liviu201/uSDX_variant/README.md

For information about configuring KiCad for this project, go to [Configuring_KiCad.md](./Configuring_KiCad.md)
