liviu201/uSDX_variant/Hardware/3D_models/RASM722BKZ.FCStd

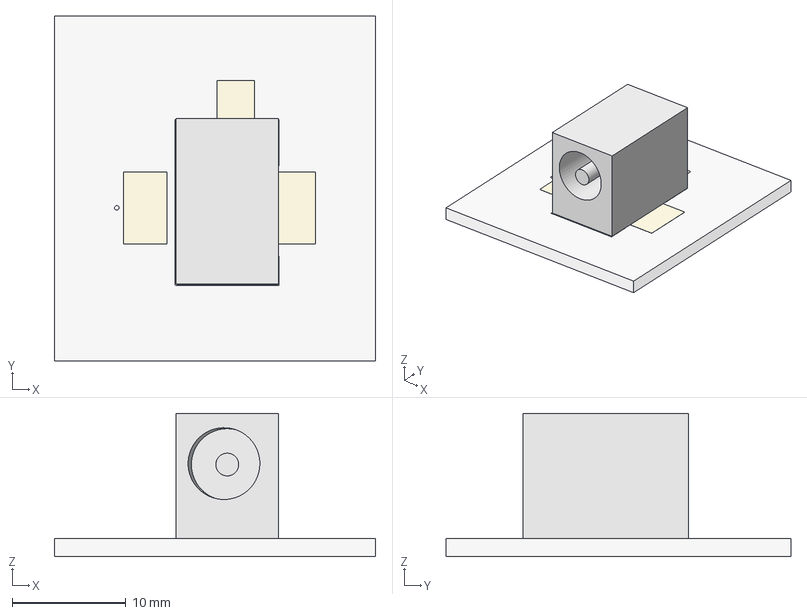
[picture p6: CAD file, 2021-12-31]
Hardware/3D_models/RASM722BKZ.FCStd
28.2 x 30.3 x 12.6 mm
FrontSilk
TopPads
Pcb
