liviu201/uSDX_variant/Hardware/3D_models/C_0805_2012Metric.step

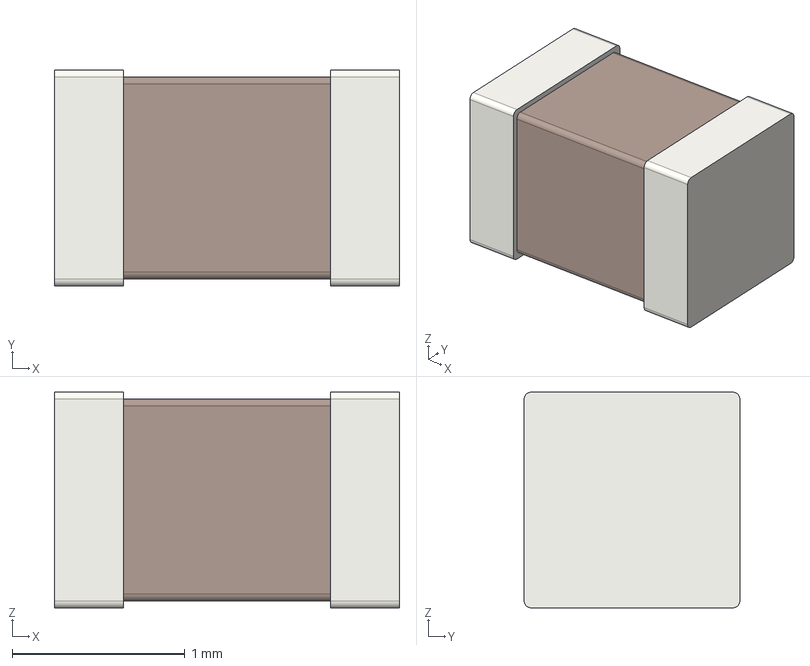
[picture p7: CAD file, 2022-01-15]
Hardware/3D_models/C_0805_2012Metric.step
2.00 x 1.25 x 1.25 mm
