liviu201/uSDX_variant/Hardware/3D_models/SamacSys_3D_Models/AZ1117CH-5.0TRG1DITR-ND.step

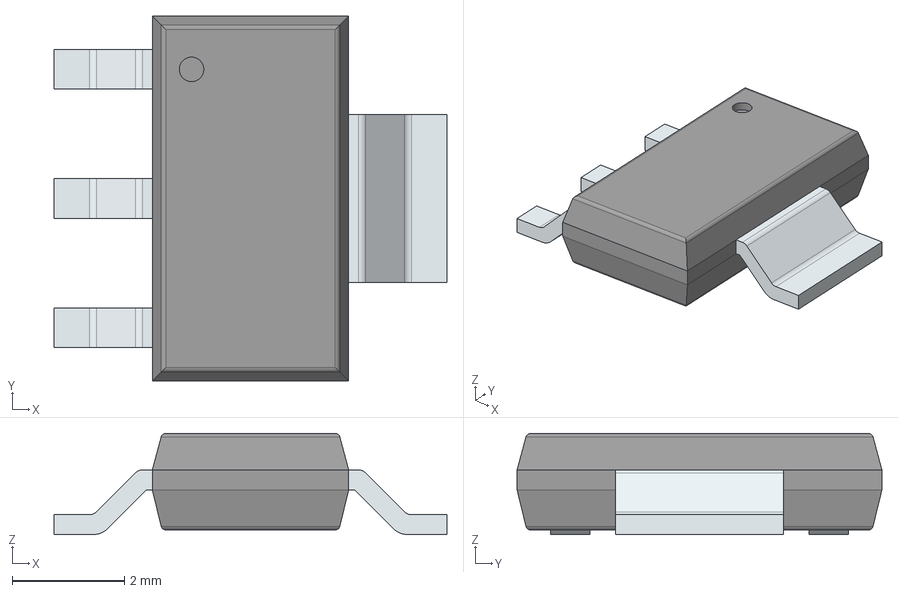
[picture p8: CAD file, 2022-01-12]
Hardware/3D_models/SamacSys_3D_Models/AZ1117CH-5.0TRG1DITR-ND.step
7.00 x 6.50 x 1.80 mm
PinsArrayL
FilletPinR
