liviu201/uSDX_variant/Hardware/3D_models/C_Disc_D3.0mm_W1.6mm_P2.50mm.step

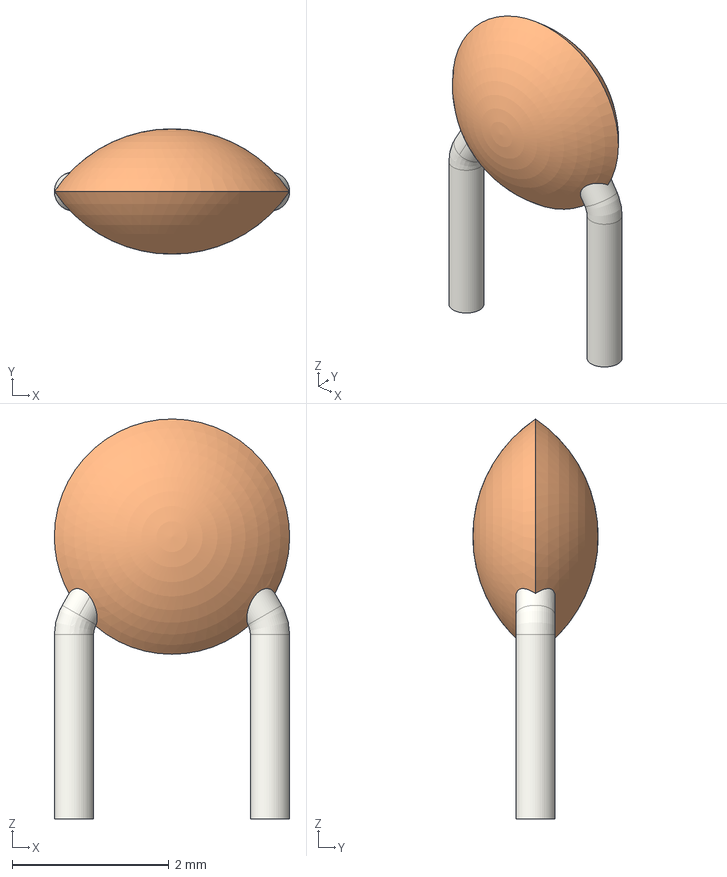
[picture p9: CAD file, 2022-01-15]
Hardware/3D_models/C_Disc_D3.0mm_W1.6mm_P2.50mm.step
3.00 x 1.60 x 5.10 mm
