liviu201/uSDX_variant/Hardware/3D_models/SamacSys_3D_Models/ECS-200-20-20BM-DP.step

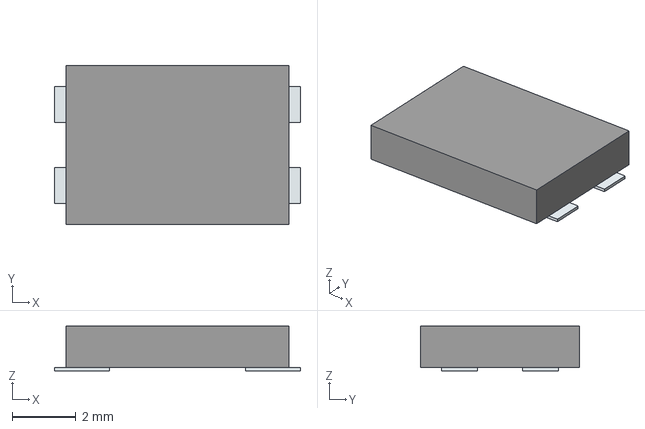
[picture p10: CAD file, 2022-01-09]
Hardware/3D_models/SamacSys_3D_Models/ECS-200-20-20BM-DP.step
7.72 x 5.00 x 1.40 mm
Pins
