liviu201/uSDX_variant/Hardware/3D_models/R_0805_2012Metric.step

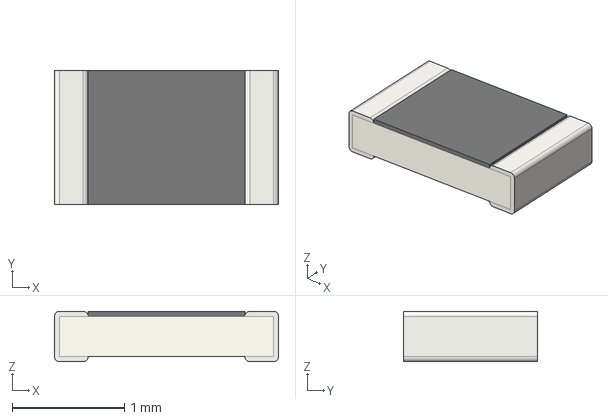
[picture p11: CAD file, 2022-01-15]
Hardware/3D_models/R_0805_2012Metric.step
2.00 x 1.20 x 0.45 mm
