liviu201/uSDX_variant/Hardware/3D_models/SamacSys_3D_Models/1N4007F.step

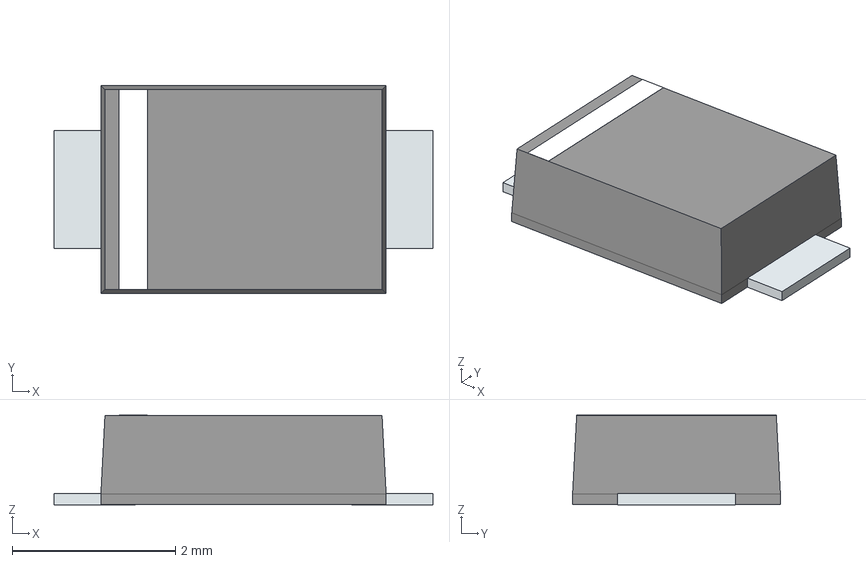
[picture p12: CAD file, 2022-01-09]
Hardware/3D_models/SamacSys_3D_Models/1N4007F.step
4.65 x 2.55 x 1.10 mm
PinKIdent
PinK
PinA
