liviu201/uSDX_variant/Hardware/3D_models/SamacSys_3D_Models/NE555DR.step

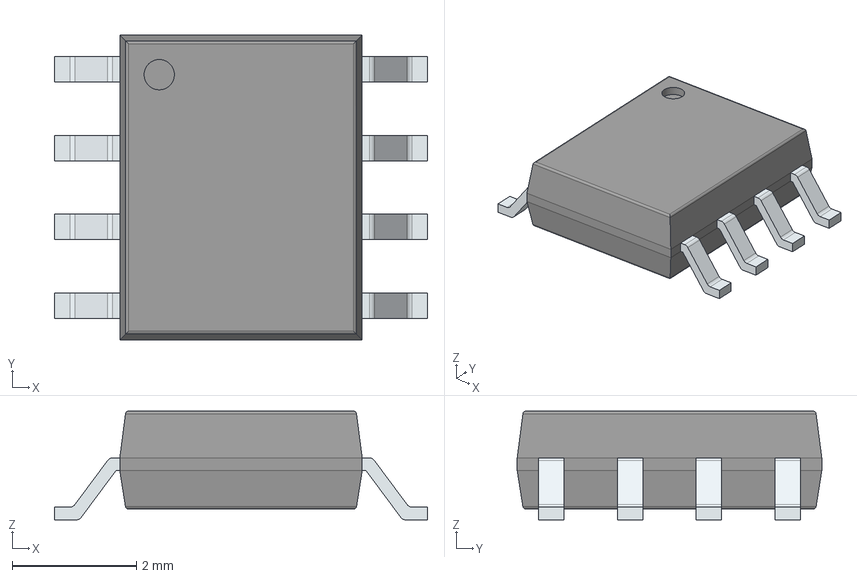
[picture p13: CAD file, 2022-01-09]
Hardware/3D_models/SamacSys_3D_Models/NE555DR.step
6.00 x 4.90 x 1.75 mm
PinsArrayLR
