liviu201/uSDX_variant/Hardware/3D_models/Toroid.step

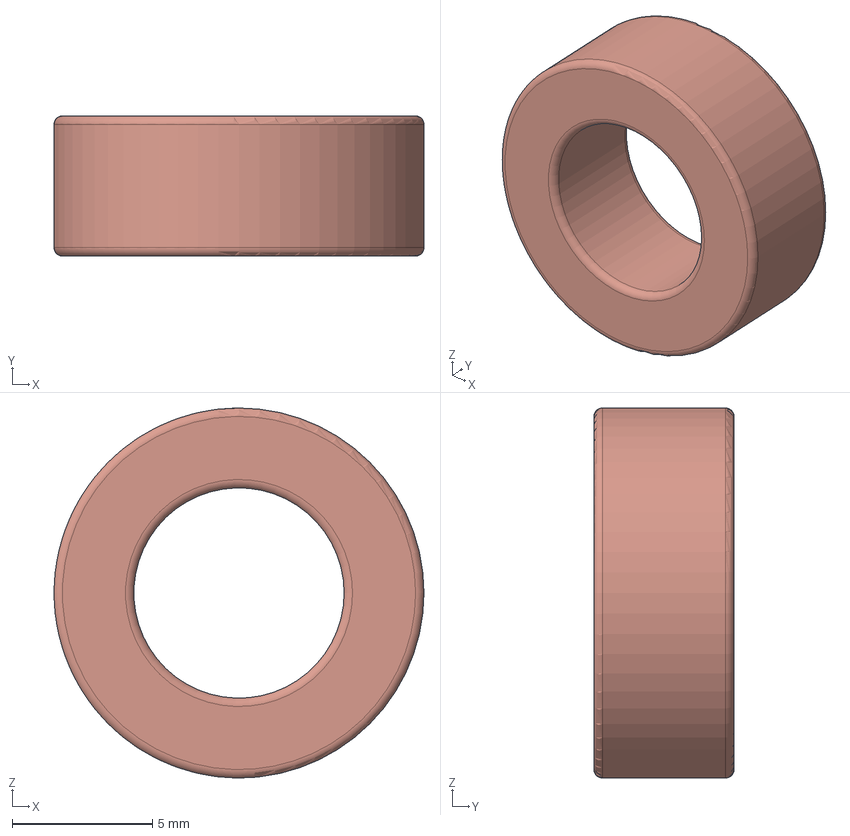
[picture p14: CAD file, 2022-01-15]
Hardware/3D_models/Toroid.step
13.2 x 5.00 x 13.2 mm
