liviu201/uSDX_variant/Hardware/3D_models/SamacSys_3D_Models/SI5351A-B-GTR.step

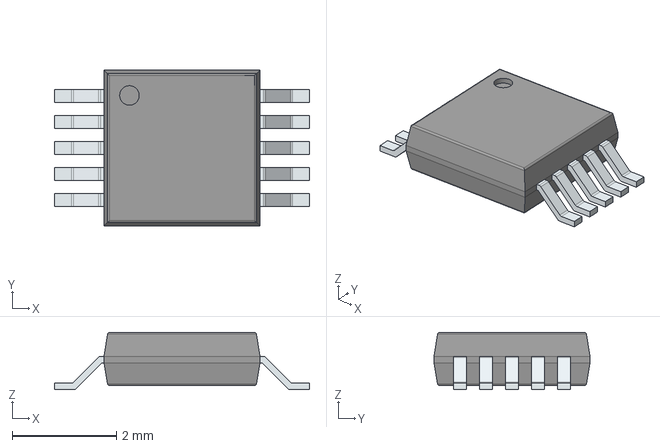
[picture p15: CAD file, 2022-01-09]
Hardware/3D_models/SamacSys_3D_Models/SI5351A-B-GTR.step
4.90 x 3.00 x 1.10 mm
PinsArrayLR
