liviu201/uSDX_variant/Hardware/3D_models/uSDX_BPF.step

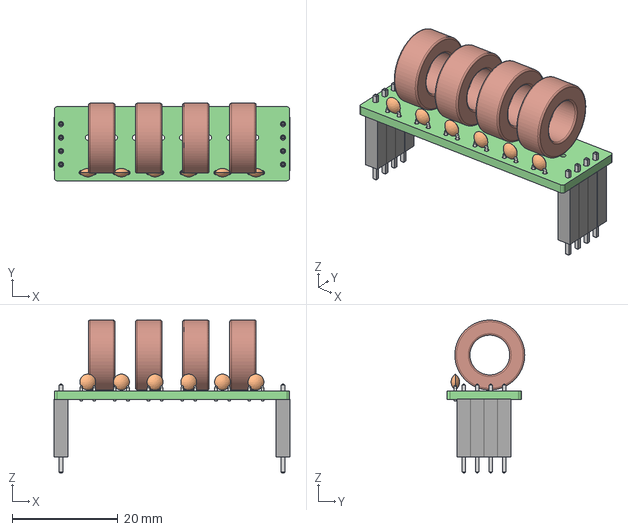
[picture p16: CAD file, 2022-01-15]
Hardware/3D_models/uSDX_BPF.step
44.5 x 14.6 x 28.8 mm
