liviu201/uSDX_variant/Hardware/3D_models/filterStandoff.step

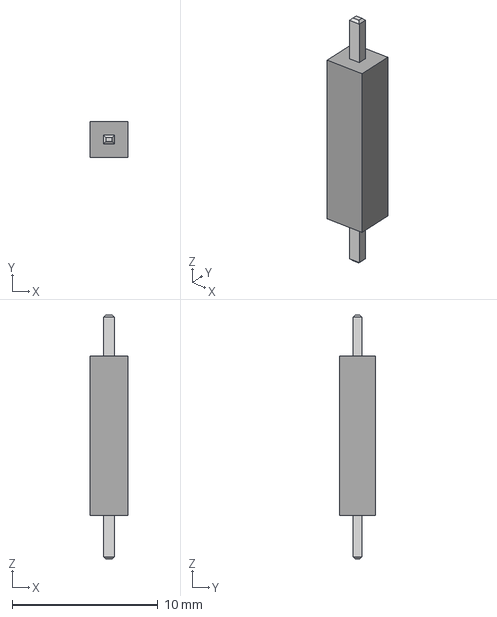
[picture p17: CAD file, 2022-01-15]
Hardware/3D_models/filterStandoff.step
2.64 x 2.50 x 16.8 mm
