liviu201/uSDX_variant/Hardware/3D_models/BPF_board.FCStd

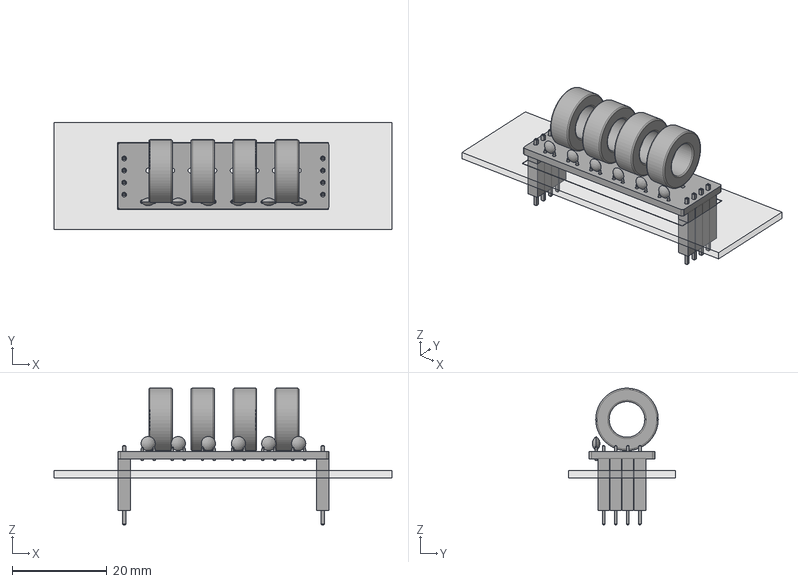
[picture p18: CAD file, 2022-01-15]
Hardware/3D_models/BPF_board.FCStd
71.3 x 22.5 x 28.8 mm
FrontSilk
TopPads
BotPads
PTHs
Pcb
uSDX_BPF
