liviu201/uSDX_variant/Hardware/3D_models/SamacSys_3D_Models/1613_14.step

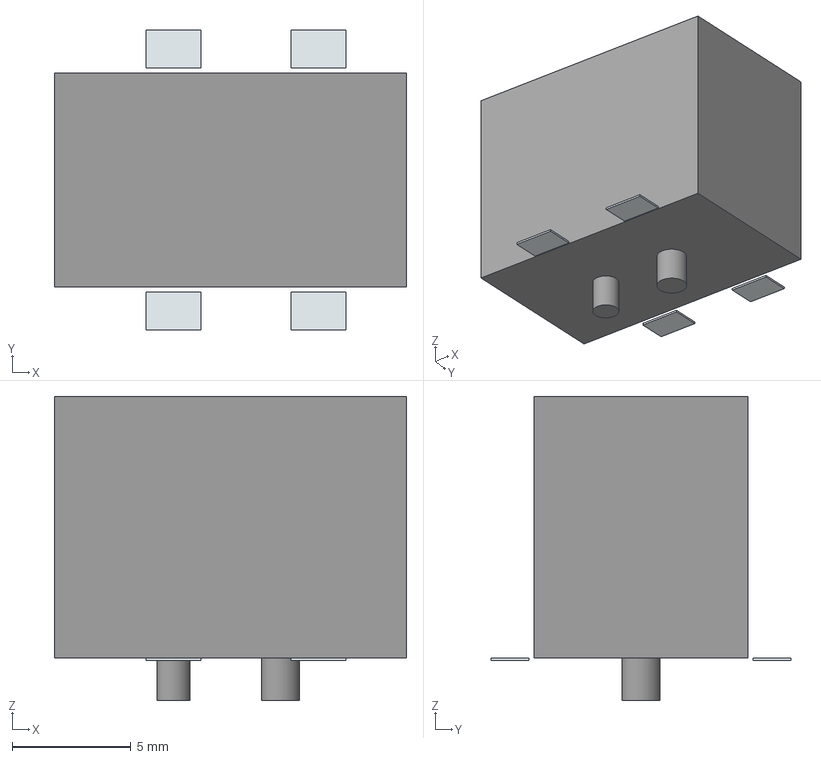
[picture p19: CAD file, 2022-01-09]
Hardware/3D_models/SamacSys_3D_Models/1613_14.step
14.8 x 12.6 x 12.8 mm
Pins
Lugs
