liviu201/uSDX_variant/Hardware/3D_models/resetButton.step

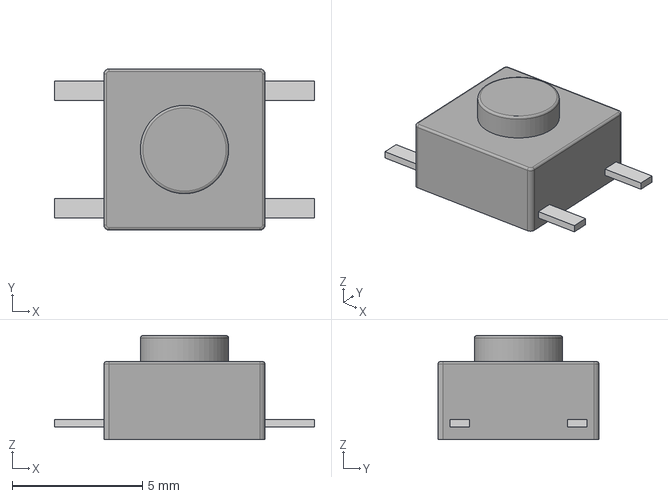
[picture p20: CAD file, 2022-01-13]
Hardware/3D_models/resetButton.step
10.0 x 6.20 x 4.00 mm
