liviu201/uSDX_variant/Hardware/3D_models/SamacSys_3D_Models/UCQ1C100MCL1GB.step

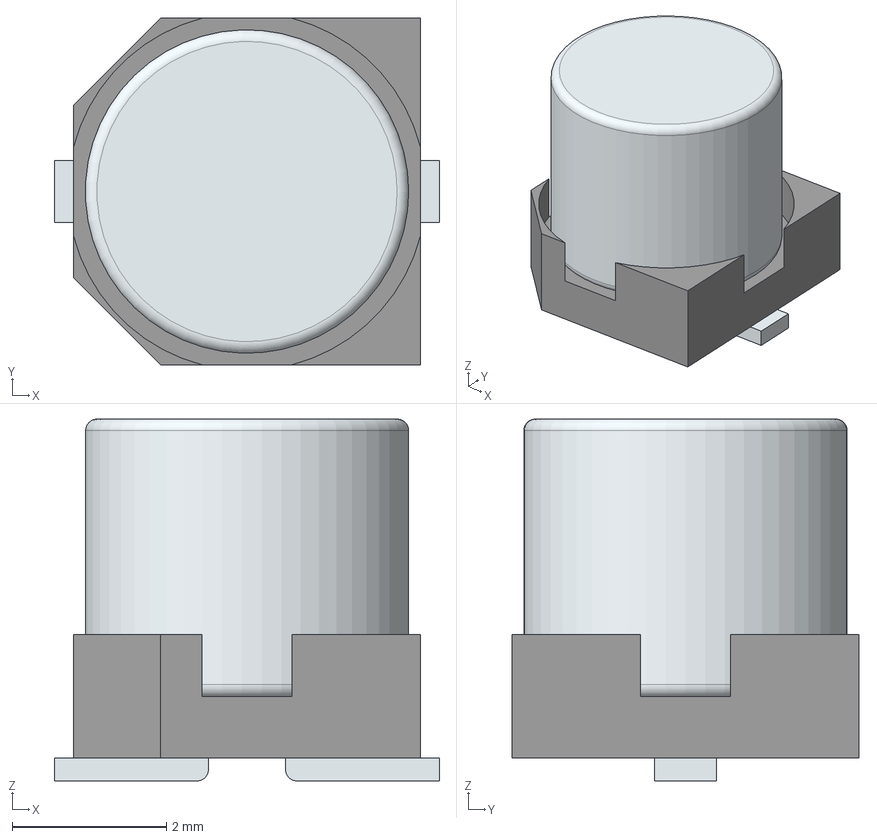
[picture p21: CAD file, 2022-01-09]
Hardware/3D_models/SamacSys_3D_Models/UCQ1C100MCL1GB.step
5.00 x 4.50 x 4.70 mm
Base
Pin1Fillet
Pin2Fillet
