liviu201/uSDX_variant/Hardware/3D_models/27Mhz_crystal.step

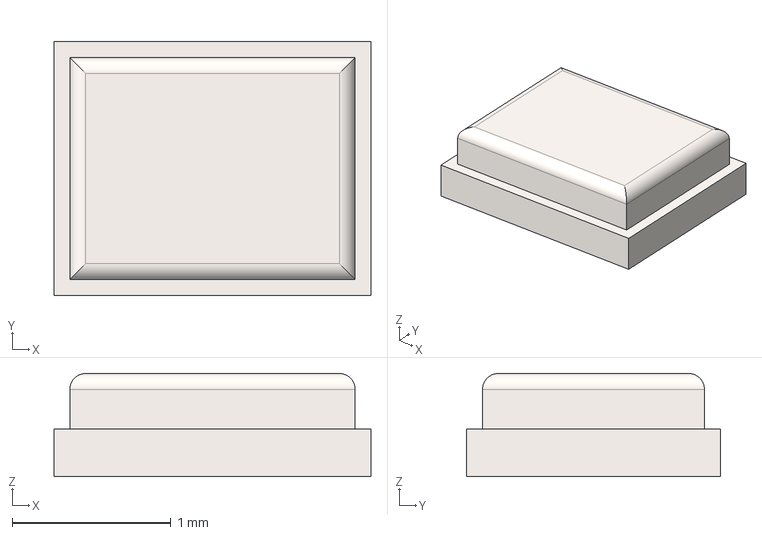
[picture p22: CAD file, 2022-01-13]
Hardware/3D_models/27Mhz_crystal.step
2.00 x 1.60 x 0.65 mm
