liviu201/uSDX_variant/Hardware/3D_models/SamacSys_3D_Models/PTS125SM122LFS.step

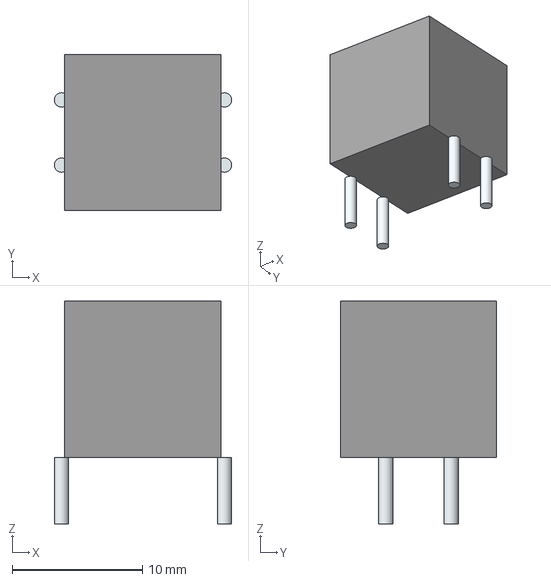
[picture p23: CAD file, 2022-01-09]
Hardware/3D_models/SamacSys_3D_Models/PTS125SM122LFS.step
13.6 x 12.0 x 17.1 mm
Leads
