liviu201/uSDX_variant/Hardware/3D_models/SamacSys_3D_Models/LM1117MPX-25NOPB.step

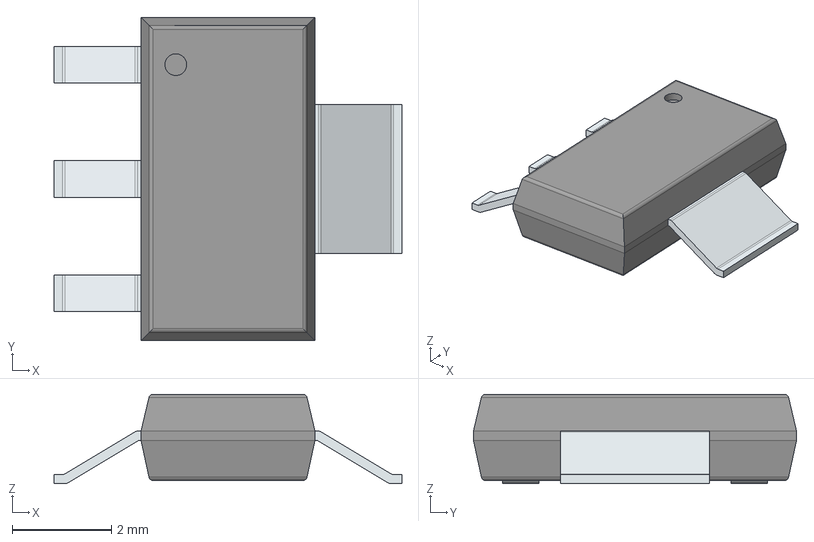
[picture p24: CAD file, 2022-01-09]
Hardware/3D_models/SamacSys_3D_Models/LM1117MPX-25NOPB.step
7.00 x 6.50 x 1.80 mm
PinsArrayL
FilletPinR
