liviu201/uSDX_variant/Hardware/3D_models/trimmer.step

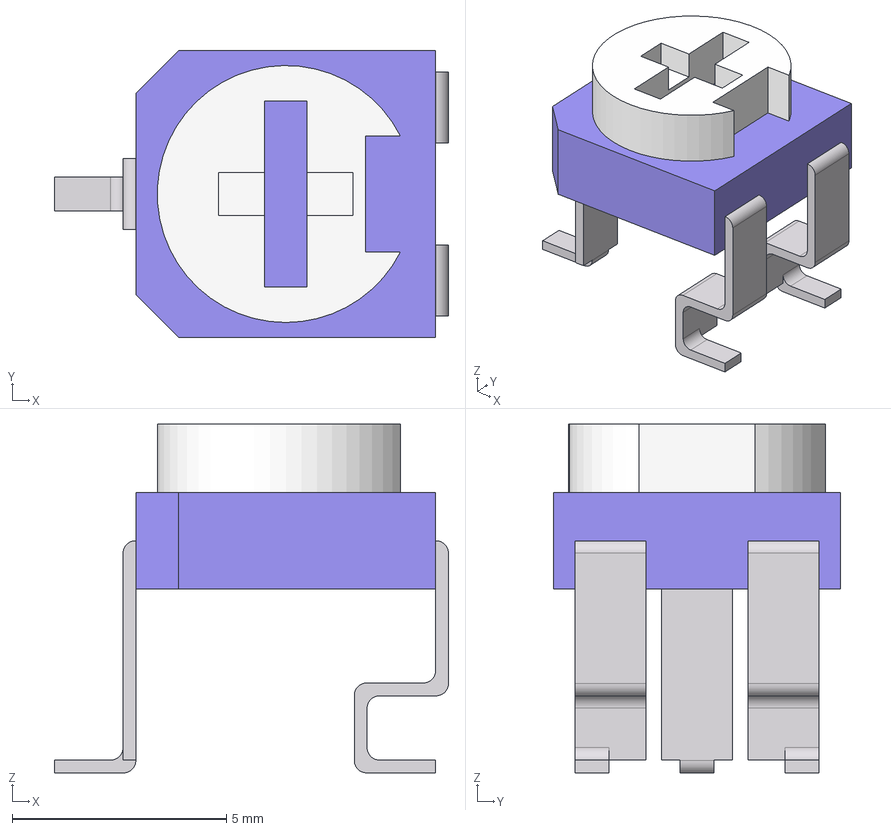
[picture p25: CAD file, 2022-01-12]
Hardware/3D_models/trimmer.step
9.20 x 6.70 x 8.14 mm
