liviu201/uSDX_variant/Hardware/3D_models/angled_socket_header.step

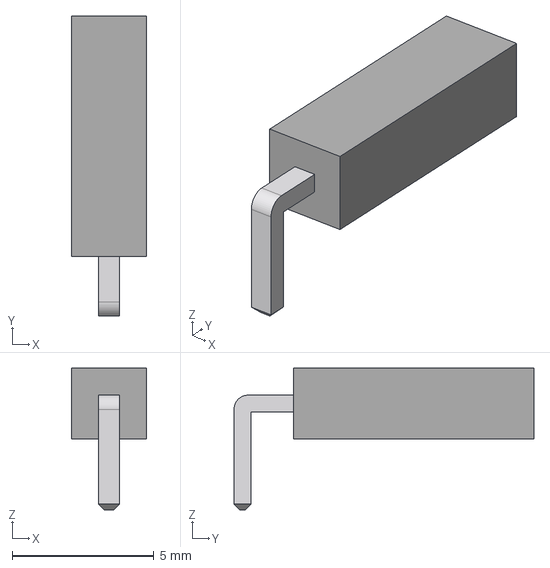
[picture p26: CAD file, 2022-01-12]
Hardware/3D_models/angled_socket_header.step
2.64 x 10.6 x 5.00 mm
