liviu201/uSDX_variant/Hardware/3D_models/SamacSys_3D_Models/FST3253MTCX.step

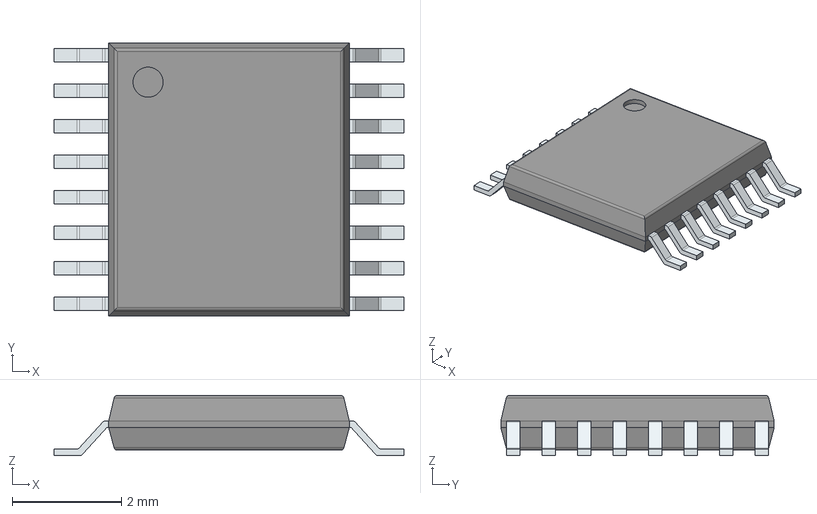
[picture p27: CAD file, 2022-01-09]
Hardware/3D_models/SamacSys_3D_Models/FST3253MTCX.step
6.40 x 5.00 x 1.10 mm
PinsArrayLR
