liviu201/uSDX_variant/Hardware/3D_models/PEC11R-4220F-S0024.stp

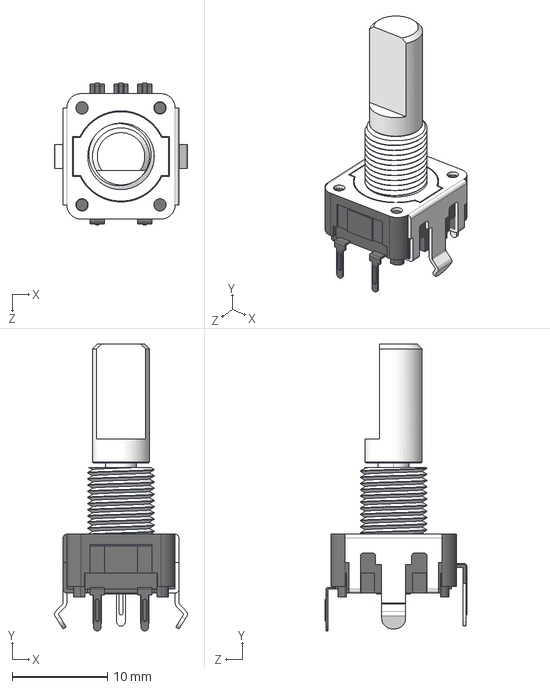
[picture p28: CAD file, 2022-01-09]
Hardware/3D_models/PEC11R-4220F-S0024.stp
14.0 x 30.2 x 14.9 mm
