liviu201/uSDX_variant/Hardware/3D_models/SamacSys_3D_Models/1N4148W_R2_00001.step

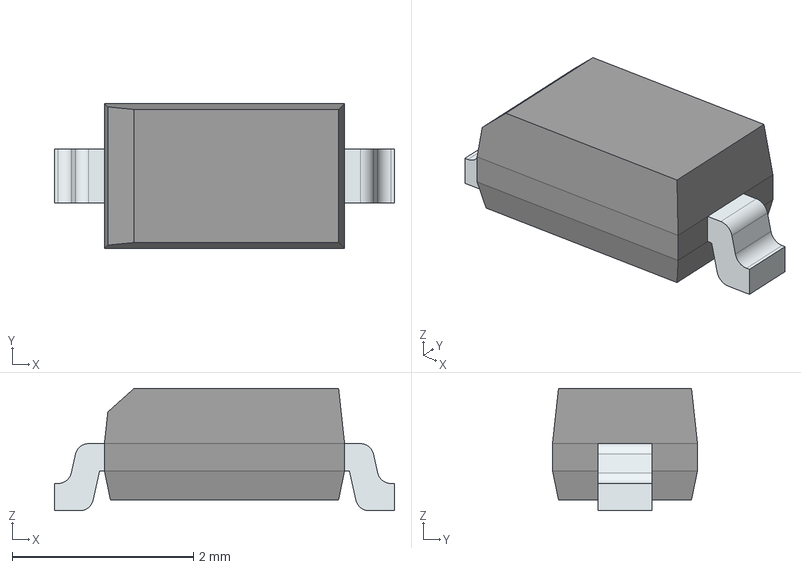
[picture p29: CAD file, 2022-01-09]
Hardware/3D_models/SamacSys_3D_Models/1N4148W_R2_00001.step
3.75 x 1.60 x 1.35 mm
FilletPinL
FilletPinR
