liviu201/uSDX_variant/Hardware/3D_models/SamacSys_3D_Models/MC74AC00DR2G.step

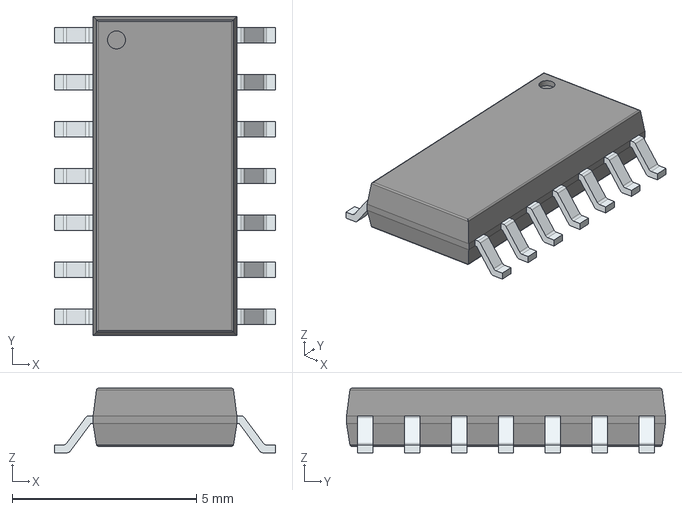
[picture p30: CAD file, 2022-01-09]
Hardware/3D_models/SamacSys_3D_Models/MC74AC00DR2G.step
6.00 x 8.65 x 1.75 mm
PinsArrayLR
