liviu201/uSDX_variant/Hardware/3D_models/SMA_conn.step

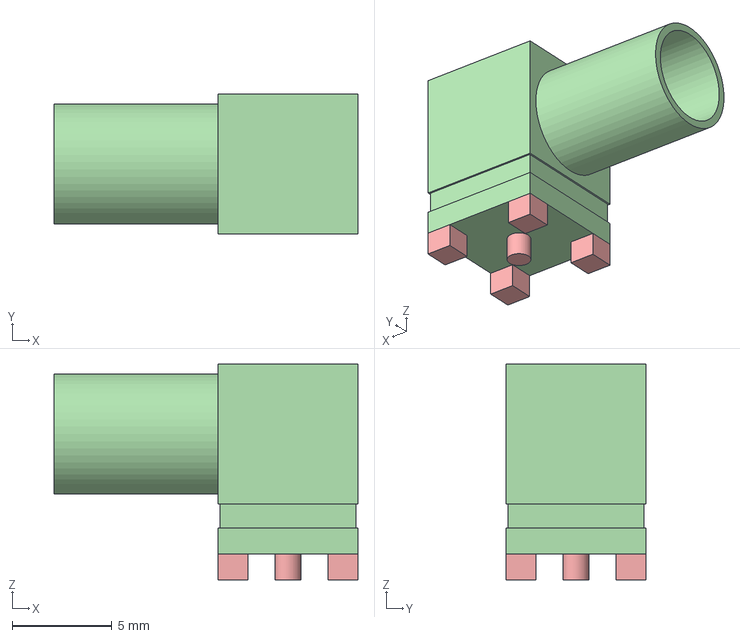
[picture p31: CAD file, 2022-01-09]
Hardware/3D_models/SMA_conn.step
15.2 x 7.00 x 10.8 mm
