liviu201/uSDX_variant/Hardware/3D_models/SamacSys_3D_Models/RC1602B-BIW-ESX.step

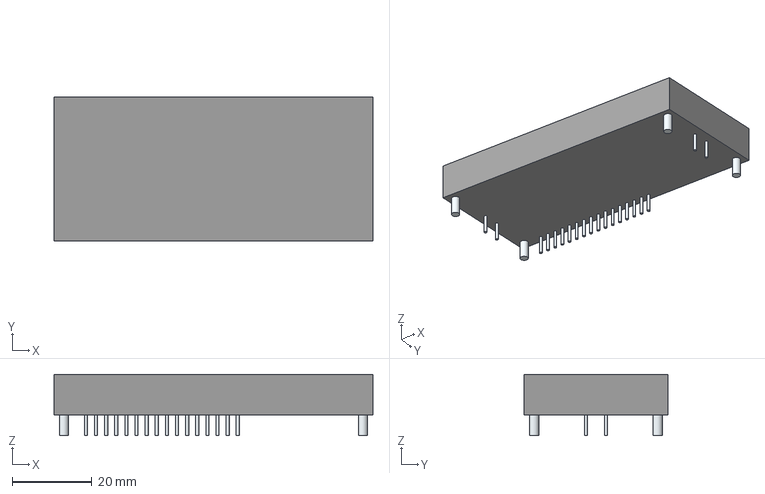
[picture p32: CAD file, 2022-01-09]
Hardware/3D_models/SamacSys_3D_Models/RC1602B-BIW-ESX.step
80.0 x 36.0 x 15.3 mm
Leads x 24
