liviu201/uSDX_variant/Hardware/3D_models/SOIC-8_3.9x4.9mm_P1.27mm.step

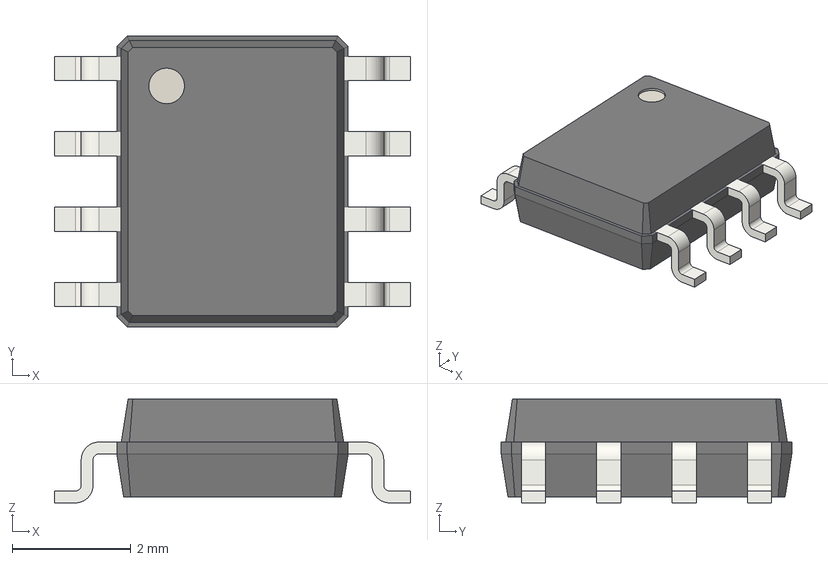
[picture p33: CAD file, 2022-01-09]
Hardware/3D_models/SOIC-8_3.9x4.9mm_P1.27mm.step
6.00 x 4.90 x 1.75 mm
