liviu201/uSDX_variant/Hardware/3D_models/MSS6122-104MLC.step

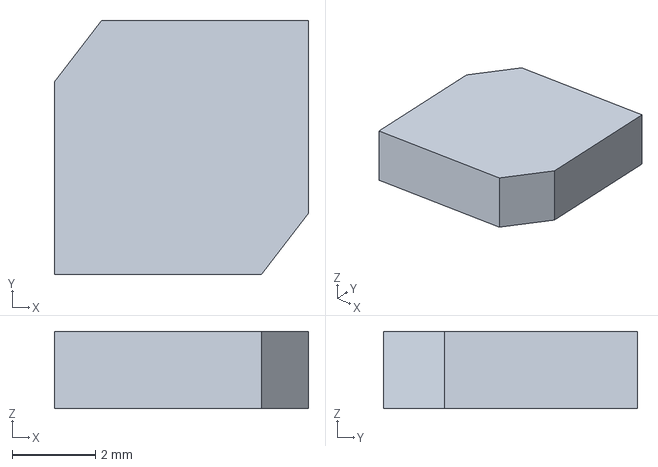
[picture p34: CAD file, 2022-01-09]
Hardware/3D_models/MSS6122-104MLC.step
6.10 x 6.10 x 1.85 mm
