liviu201/uSDX_variant/Hardware/3D_models/SamacSys_3D_Models/16PJ200.step

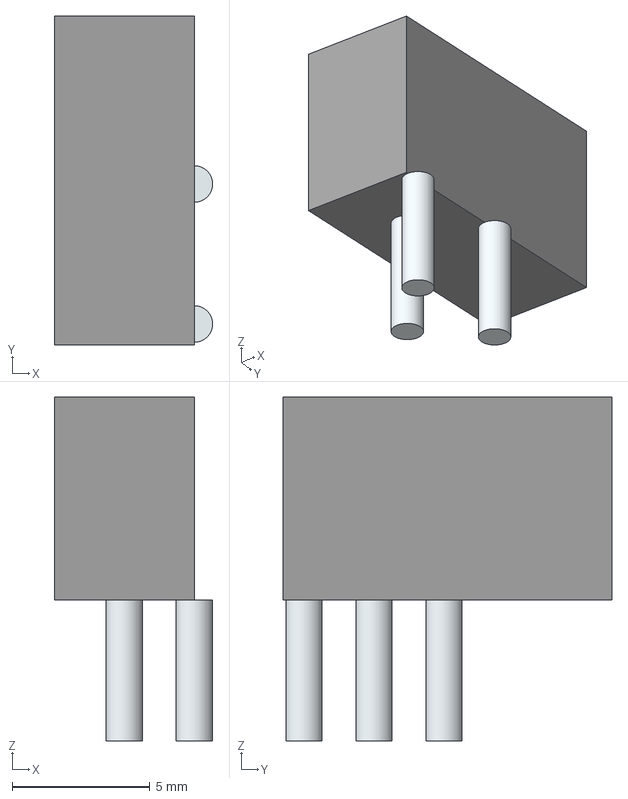
[picture p35: CAD file, 2022-01-09]
Hardware/3D_models/SamacSys_3D_Models/16PJ200.step
5.74 x 11.9 x 12.5 mm
Leads
