liviu201/uSDX_variant/Hardware/3D_models/QFP32.step

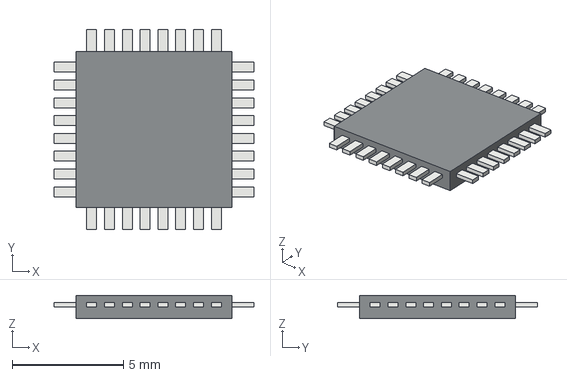
[picture p36: CAD file, 2022-01-09]
Hardware/3D_models/QFP32.step
8.98 x 8.98 x 1.05 mm
