liviu201/uSDX_variant/Hardware/3D_models/SamacSys_3D_Models/ATMEGA16A-AU.step

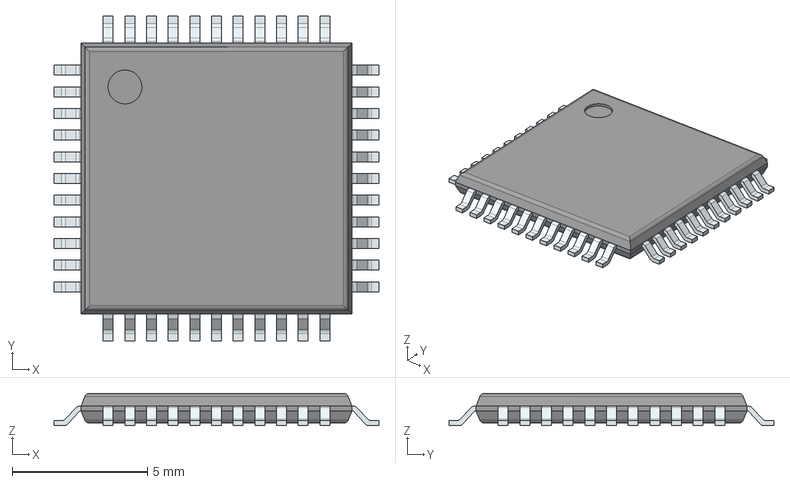
[picture p37: CAD file, 2022-01-09]
Hardware/3D_models/SamacSys_3D_Models/ATMEGA16A-AU.step
12.0 x 12.0 x 1.20 mm
PinsArrayLR
PinsArrayTB
