liviu201/uSDX_variant/Hardware/3D_models/CUI_-_SJ-43514-SMT.step

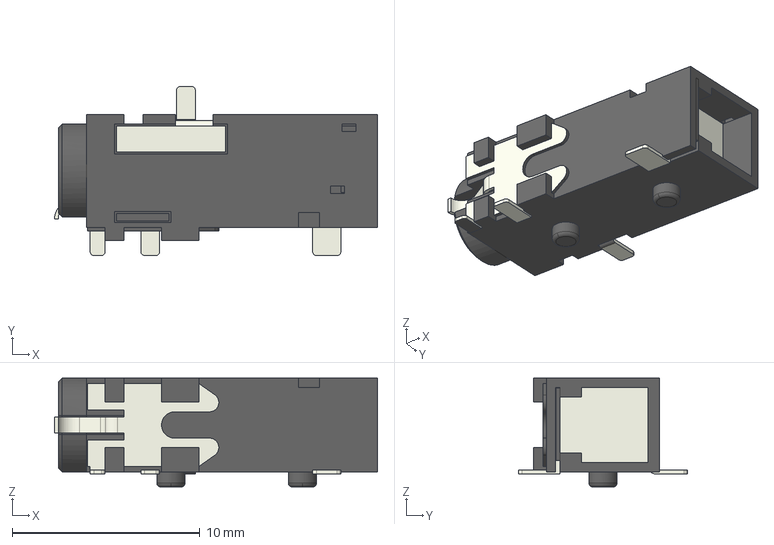
[picture p38: CAD file, 2022-01-09]
Hardware/3D_models/CUI_-_SJ-43514-SMT.step
17.2 x 9.00 x 5.80 mm
