liviu201/uSDX_variant/Hardware/3D_models/SamacSys_3D_Models/ATMEGA328P-ANR.step

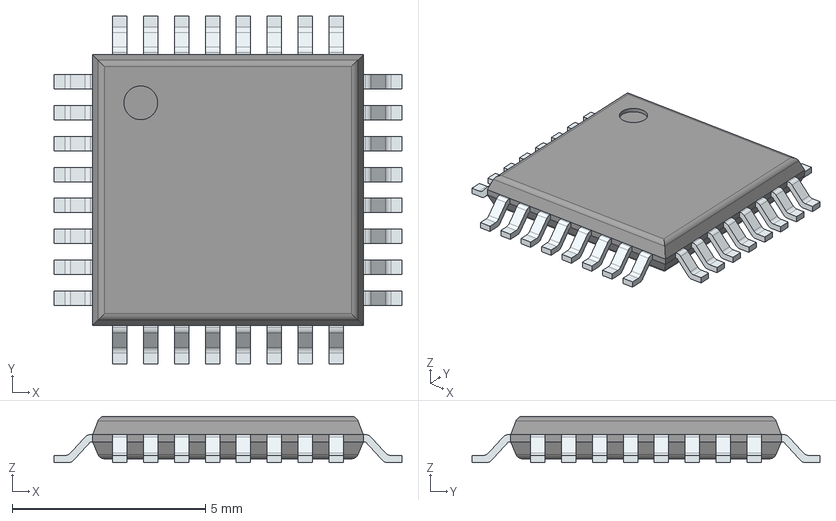
[picture p39: CAD file, 2022-01-09]
Hardware/3D_models/SamacSys_3D_Models/ATMEGA328P-ANR.step
9.00 x 9.00 x 1.20 mm
PinsArrayLR
PinsArrayTB
