liviu201/uSDX_variant/Hardware/3D_models/AtMega328p.FCStd

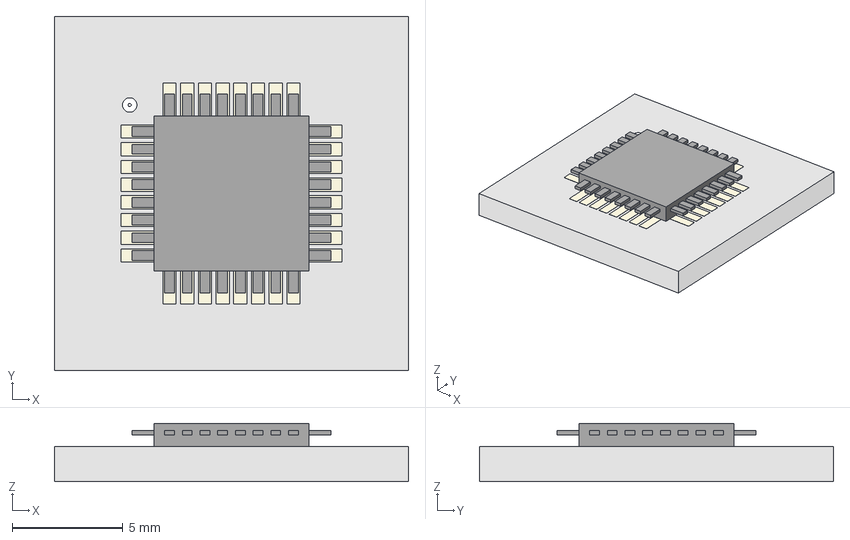
[picture p40: CAD file, 2022-01-09]
Hardware/3D_models/AtMega328p.FCStd
16.0 x 16.0 x 2.64 mm
FrontSilk
TopPads
Pcb
QFP32
