liviu201/uSDX_variant/Hardware/3D_models/VLS3010CX-101M-1.step

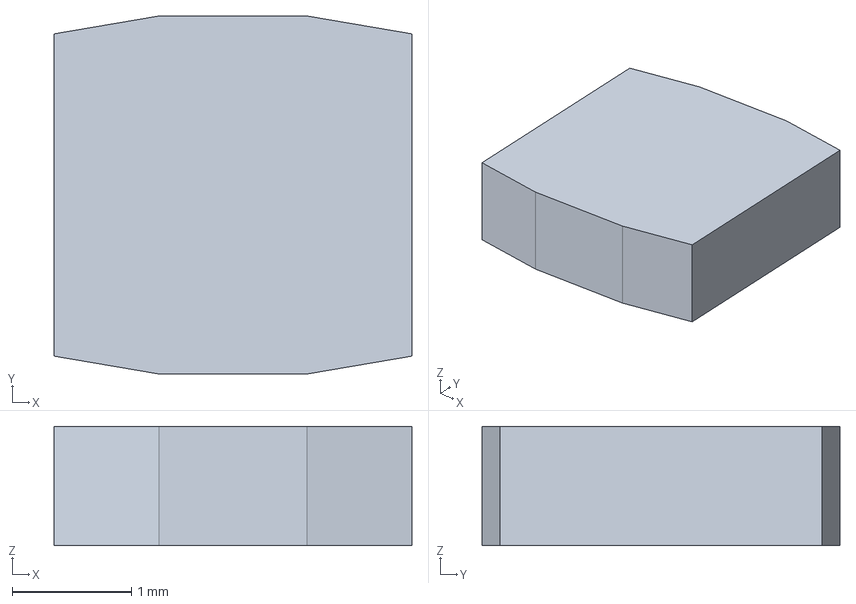
[picture p41: CAD file, 2022-01-09]
Hardware/3D_models/VLS3010CX-101M-1.step
3.00 x 3.00 x 1.00 mm
