liviu201/uSDX_variant/Hardware/3D_models/EEE-FK1C101SR.stp

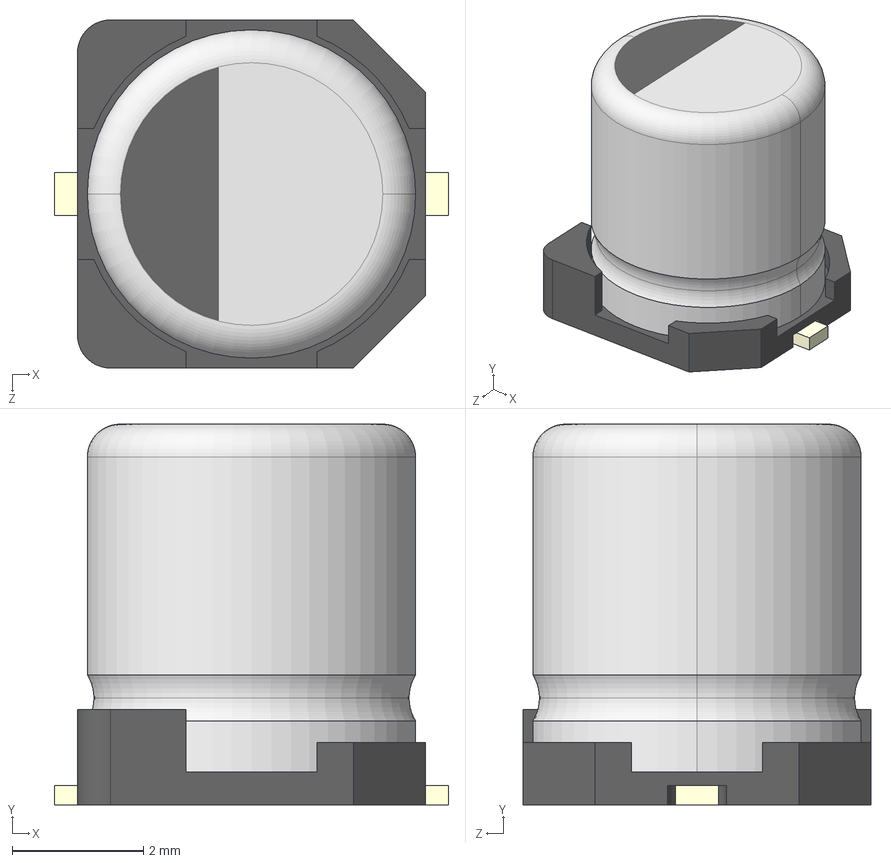
[picture p42: CAD file, 2022-01-09]
Hardware/3D_models/EEE-FK1C101SR.stp
6.00 x 5.80 x 5.30 mm
標準SIZE CODE C-001
標準SIZE CODE C-002
標準SIZE CODE C-003 x 2
