liviu201/uSDX_variant/Hardware/3D_models/SMA_connector.FCStd

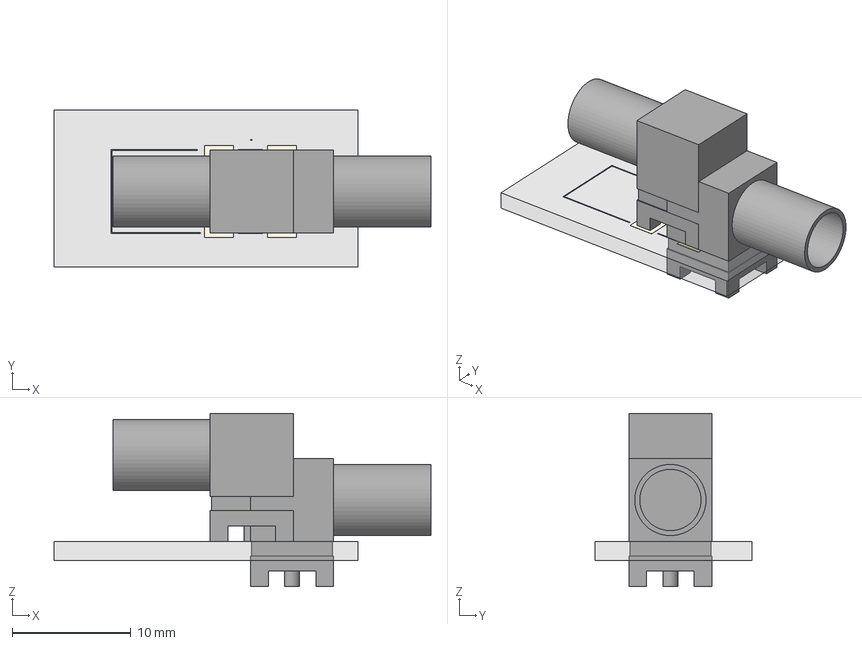
[picture p43: CAD file, 2022-01-09]
Hardware/3D_models/SMA_connector.FCStd
31.8 x 13.2 x 14.6 mm
FrontSilk
TopPads
Pcb
SMA_conn
