liviu201/uSDX_variant/Hardware/3D_models/WC1602A.step

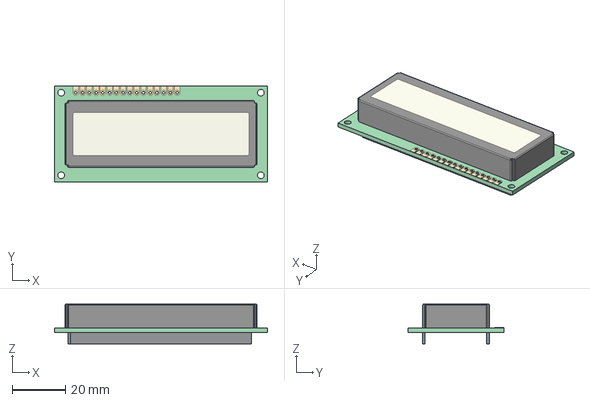
[picture p44: CAD file, 2022-01-09]
Hardware/3D_models/WC1602A.step
80.0 x 36.0 x 15.0 mm
