liviu201/uSDX_variant/Hardware/3D_models/TO-92.step

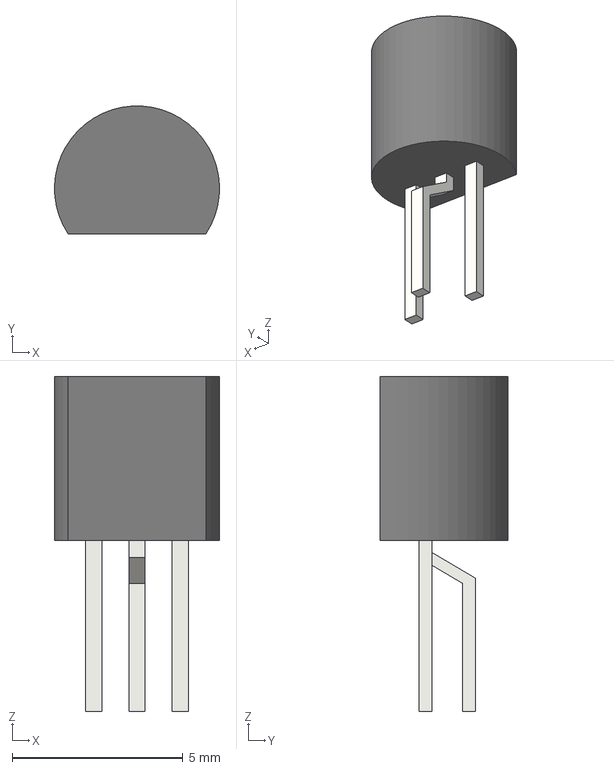
[picture p45: CAD file, 2022-01-09]
Hardware/3D_models/TO-92.step
4.83 x 3.74 x 9.80 mm
