liviu201/uSDX_variant/Hardware/3D_models/STX-3150-3C-1.step

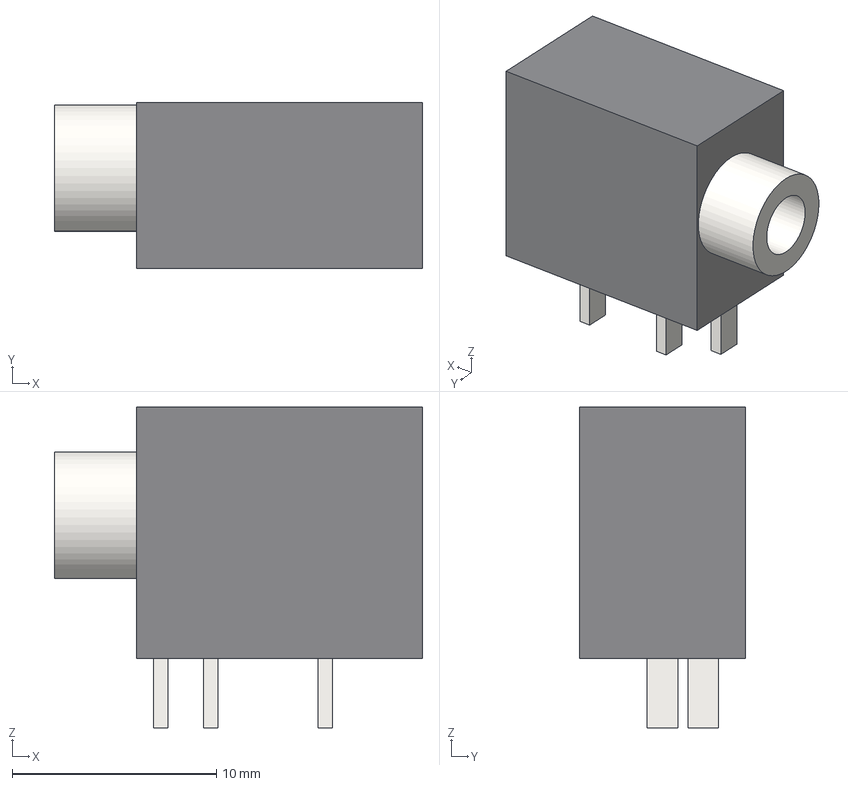
[picture p46: CAD file, 2022-01-09]
Hardware/3D_models/STX-3150-3C-1.step
18.0 x 8.10 x 15.7 mm
