liviu201/uSDX_variant/Hardware/3D_models/Button.step

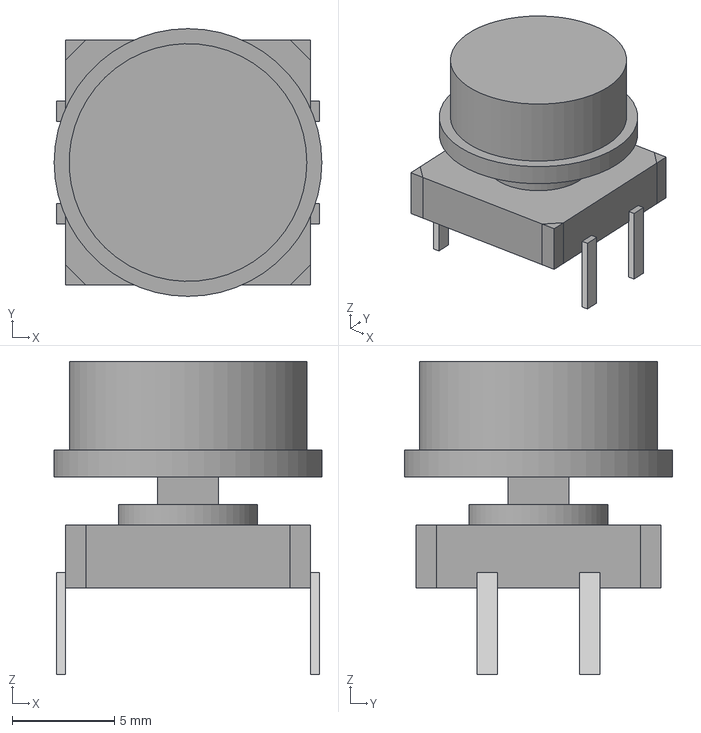
[picture p47: CAD file, 2022-01-09]
Hardware/3D_models/Button.step
13.1 x 13.1 x 15.3 mm
