liviu201/uSDX_variant/Hardware/3D_models/ABLS-20.000MHZ-20-B-3-H-T.FCStd

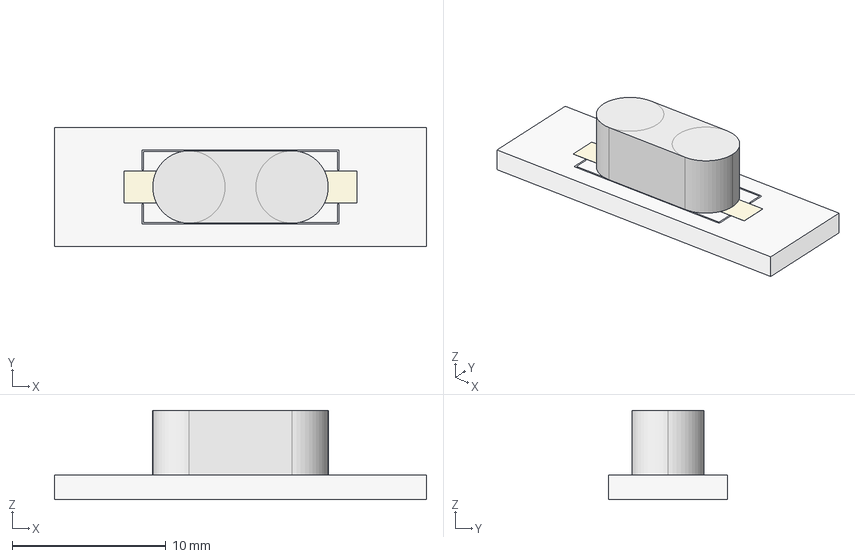
[picture p48: CAD file, 2021-12-31]
Hardware/3D_models/ABLS-20.000MHZ-20-B-3-H-T.FCStd
24.2 x 7.71 x 5.79 mm
FrontSilk
TopPads
Pcb
Connect
