liviu201/uSDX_variant/Hardware/3D_models/Connect.step

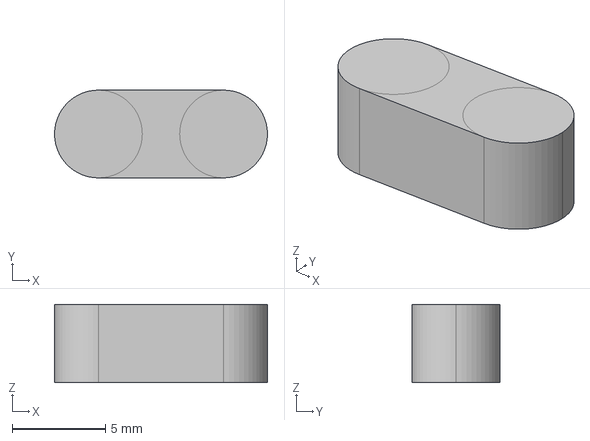
[picture p49: CAD file, 2021-12-31]
Hardware/3D_models/Connect.step
11.4 x 4.70 x 4.20 mm
