liviu201/uSDX_variant/Hardware/3D_models/Fusion.step

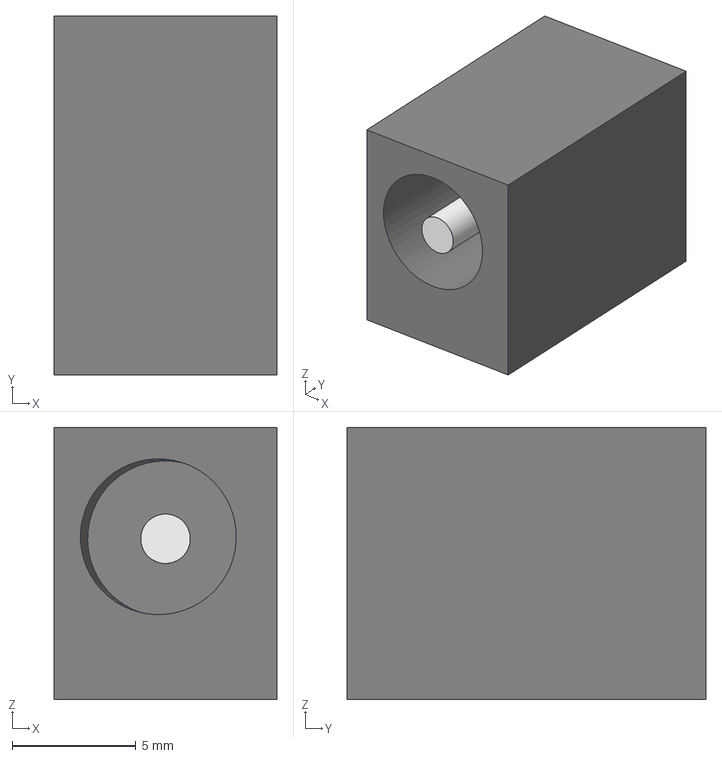
[picture p50: CAD file, 2021-12-31]
Hardware/3D_models/Fusion.step
9.00 x 14.5 x 11.0 mm
