liviu201/uSDX_variant/(list of files, cad)

Other CAD files:
Hardware/3D_models/Body.step
Hardware/3D_models/SamacSys_3D_Models/LM1117MPX-50NOPB.step
Hardware/3D_models/27Mhz_crystal.FCStd
Hardware/3D_models/CUI_-_SJ-43514-SMT.FCStd
Hardware/3D_models/EEE-FK1C101SR.FCStd
Hardware/3D_models/MSS6122-104MLC.FCStd
Hardware/3D_models/STX-3150-3C-1.FCStd
Hardware/3D_models/SamacSys_3D_Models/830108207209.step
Hardware/3D_models/Toroid.FCStd
Hardware/3D_models/VLS3010CX-101M-1.FCStd
Hardware/3D_models/angled_socket_header.FCStd
Hardware/3D_models/button.FCStd
Hardware/3D_models/filterStandoff.FCStd
Hardware/3D_models/reset_button.FCStd
Hardware/3D_models/trimmer.FCStd
