liviu201/uSDX_variant/Hardware/uSDX_Transceiver_SMD/uSDX_Transceiver_SMD.kicad_pcb

## KiCad design Hardware/uSDX_Transceiver_SMD/uSDX_Transceiver_SMD.kicad_pcb (2022-01-16)

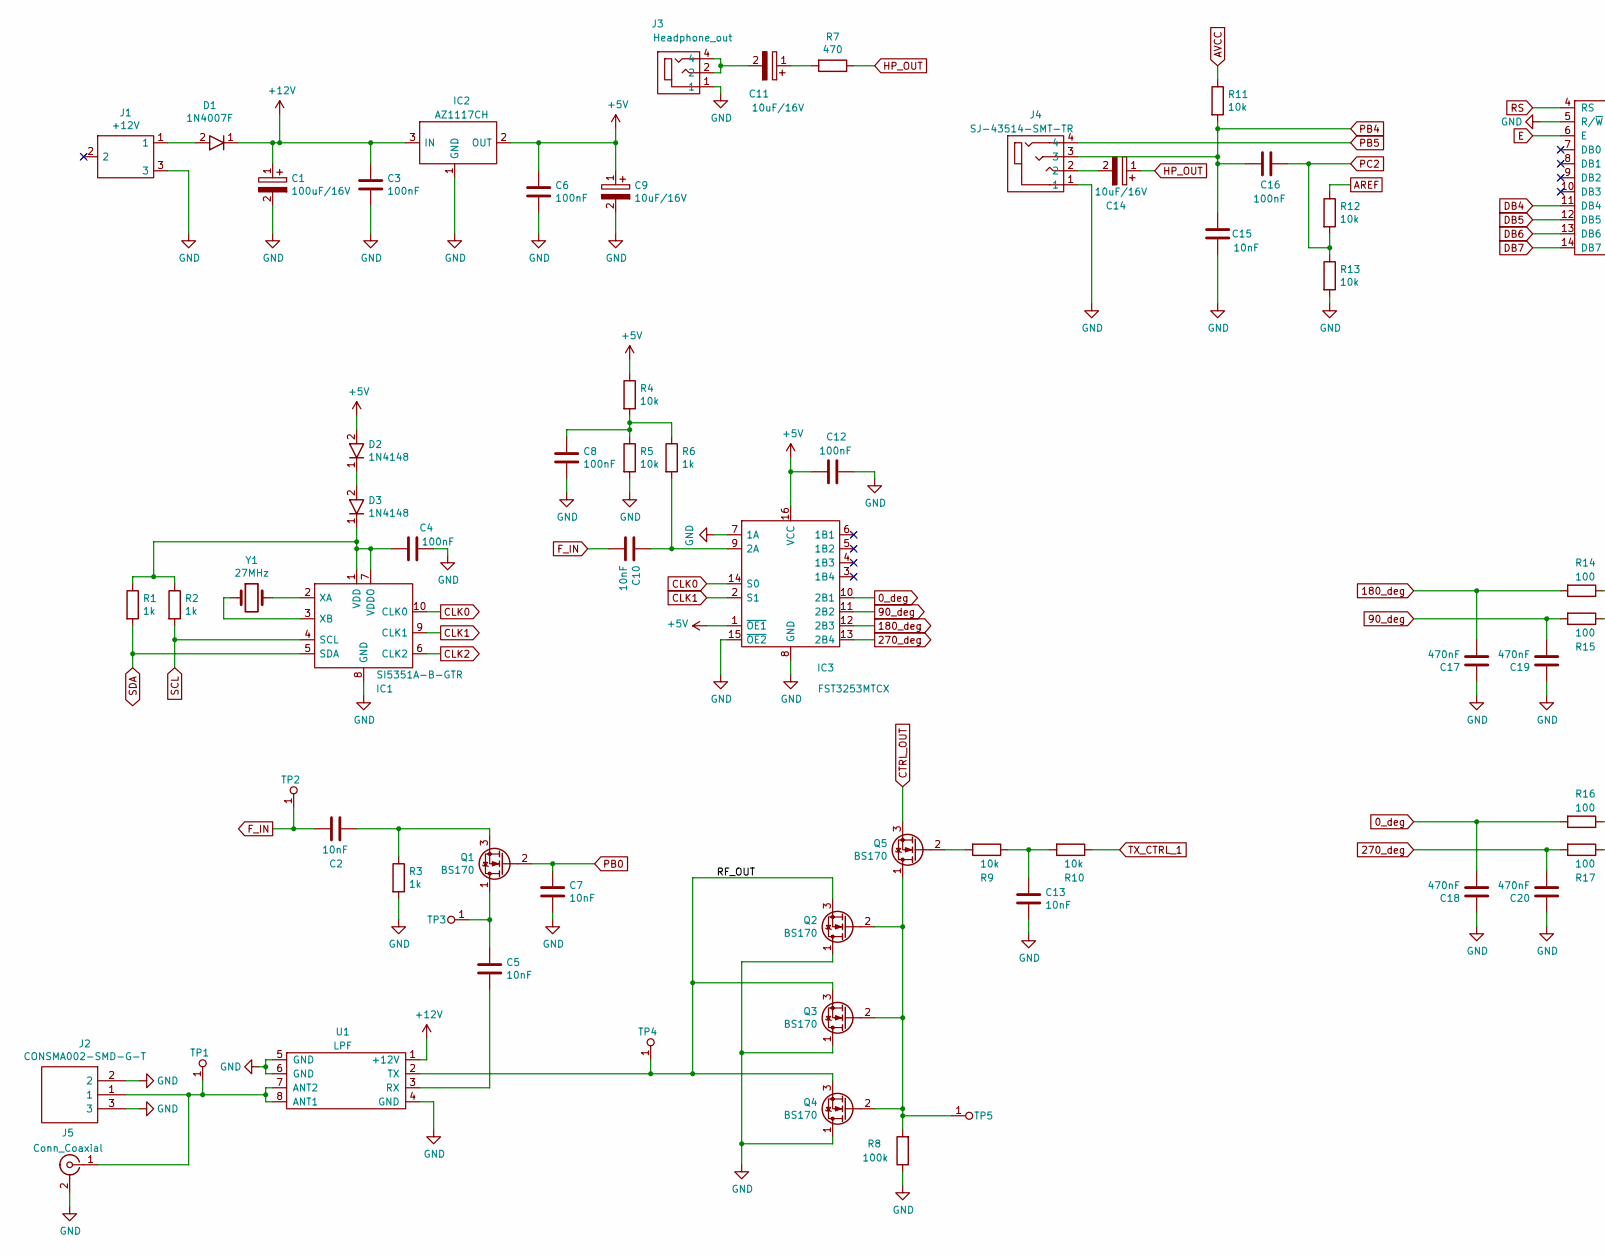
[picture p63: schematic uSDX_Transceiver_SMD.kicad_sch, part in row 1, column 1]

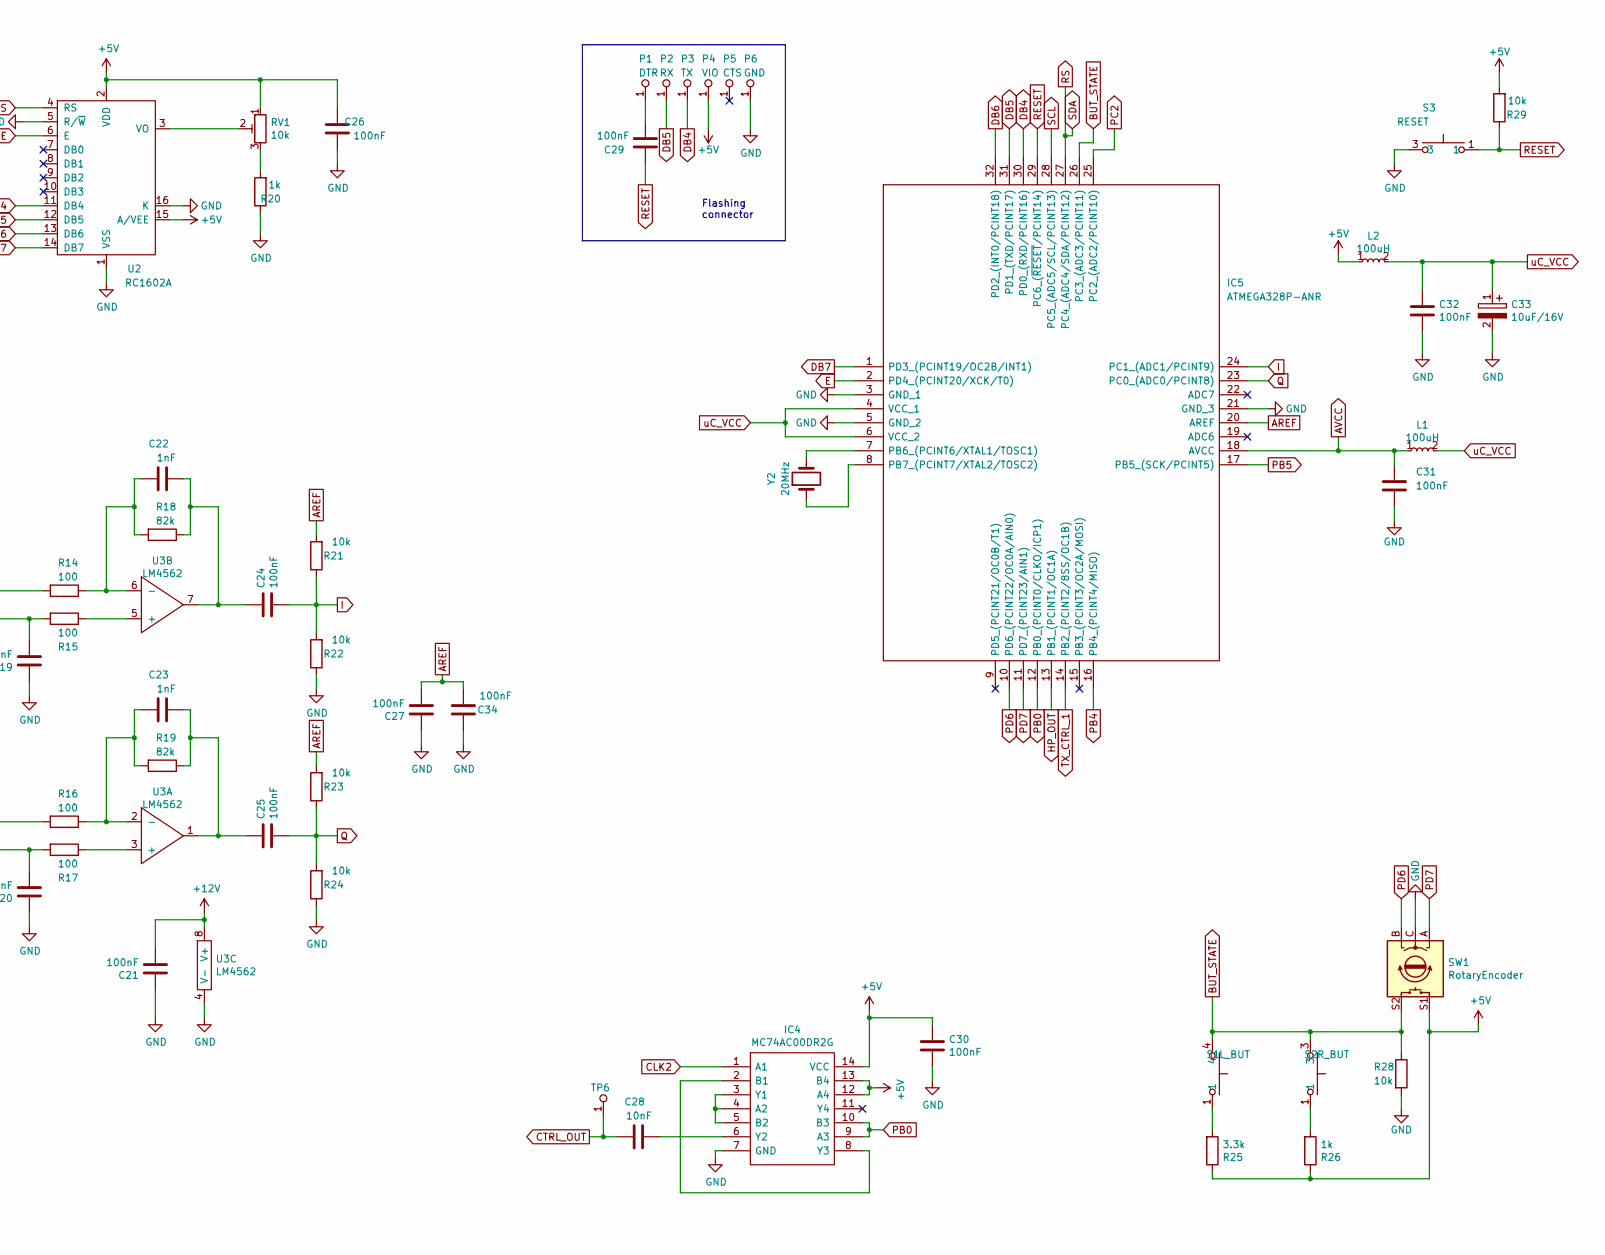
[picture p64: schematic uSDX_Transceiver_SMD.kicad_sch, part in row 1, column 2]

Parts:
C1: 100uF/16V; EEE0GA101SR; Manufacturer_Part_Number EEE-FK1C101SR; Mouser Part Number 667-EEE-FK1C101SR
C2, C5, C7, C10, C13, C15, C28: 10nF; C_0805_2012Metric
C3, C4, C6, C8, C12, C16, C21, C24, C25, C26, C27, C29, C30, C31, C32, C34: 100nF; C_0805_2012Metric
C9, C11, C14, C33: 10uF/16V; CAPAE430X470N; Manufacturer_Part_Number UCQ1C100MCL1GB; Mouser Part Number 647-UCQ1C100MCL1GB
C17, C18, C19, C20: 470nF; C_0805_2012Metric
C22, C23: 1nF; C_0805_2012Metric
D1: 1N4007F; SODFL4626X110N; Manufacturer_Part_Number 1N4007F
D2, D3: 1N4148; SOD3816X135N; Manufacturer_Part_Number 1N4148W_R2_00001; Mouser Part Number 241-1N4148W_R2_00001
IC1: SI5351A-B-GTR; SOP50P490X110-10N; Manufacturer_Part_Number SI5351A-B-GTR; Mouser Part Number 634-SI5351A-B-GTR
IC2: AZ1117CH; SOT230P700X180-4N; Manufacturer_Part_Number LM1117MPX-50NOPB; Mouser Part Number 863-LM1117MPX-50NOPB
IC3: FST3253MTCX; SOP65P640X110-16N; Manufacturer_Part_Number FST3253MTCX; Mouser Part Number 512-FST3253MTCX
IC4: MC74AC00DR2G; SOIC127P600X175-14N; Manufacturer_Part_Number MC74AC00DR2G; Mouser Part Number 863-MC74AC00DR2G
IC5: ATMEGA328P-ANR; QFP80P900X900X120-32N; Manufacturer_Part_Number ATMEGA328P-ANR; Mouser Part Number 556-ATMEGA328P-ANR
J1: +12V; RASM722BKZ; Manufacturer_Part_Number 16PJ200
J2: CONSMA002-SMD-G-T; CONSMA002SMDGT; Manufacturer_Part_Number CONSMA002-SMD-G-T; Mouser Part Number 712-CONSMA002-SMD-GT
J3: Headphone_out; STX31503C1; Manufacturer_Part_Number STX-3150-3C-1; Mouser Part Number 806-STX-3150-3C-1
J4: SJ-43514-SMT-TR; SJ43514SMTTR; Manufacturer_Part_Number SJ-43514-SMT-TR; Mouser Part Number 490-SJ-43514-SMT-TR
J5: Conn_Coaxial; BNC_1-1634613-0
L1: 100uH; VLS3010CX-101M-1
L2: 100uH; MSS6122-104MLC
P1: DTR; pin_angled
P2: RX; pin_angled
P3: TX; pin_angled
P4: VIO; pin_angled
P5: CTS; pin_angled
P6: GND; pin_angled
Q1, Q2, Q3, Q4, Q5: BS170; TO-92
R1, R2, R3, R6, R20, R26: 1k; R_0805_2012Metric
R4, R5, R9, R10, R11, R12, R13, R21, R22, R23, R24, R28, R29: 10k; R_0805_2012Metric
R7: 470; R_0805_2012Metric
R8: 100k; R_0805_2012Metric
R14, R15, R16, R17: 100; R_0805_2012Metric
R18, R19: 82k; R_0805_2012Metric
R25: 3.3k; R_0805_2012Metric
RV1: 10k; Potentiometer_Vishay_TS53YJ_Vertical
S1: L_BUT; PTS125SM122LFS; Manufacturer_Part_Number PTS125SM122LFS; Mouser Part Number 611-PTS125SM12LFS
S2: R_BUT; PTS125SM122LFS; Manufacturer_Part_Number PTS125SM122LFS; Mouser Part Number 611-PTS125SM12LFS
S3: RESET; pushbutton; Manufacturer_Part_Number PTS125SM122LFS; Mouser Part Number 611-PTS125SM12LFS
SW1: RotaryEncoder; PEC11H-4220F-S0024
TP1, TP2, TP3, TP4, TP5, TP6: testpoint
U1: LPF; BPF_board
U2: RC1602A; RC1602BBIWESX
U3: LM4562; SOIC127P600X175-8N
Y1: 27MHz; XRCGB27M000F2P01R0
Y2: 20MHz; 830108207209

Connections:
0_deg: C18.2, IC3.10 (2B1), R16.2
90_deg: C19.2, IC3.11 (2B2), R15.2
180_deg: C17.2, IC3.12 (2B3), R14.2
270_deg: C20.2, IC3.13 (2B4), R17.2
+5V: C6.1, C9.1, C12.2, C26.2, C30.1, D2.2, IC2.2 (OUT), IC3.1 (~OE1), IC3.16 (VCC), IC4.12 (A4), IC4.13 (B4), IC4.14 (VCC), L2.1, P4.1, R4.1, R25.1, R26.1, R29.2, RV1.1, SW1.S1, U2.2 (VDD), U2.15 (A/VEE)
+12V: C1.1, C3.1, C21.2, D1.1, IC2.3 (IN), U1.1 (+12V), U3.8 (V+)
/RF_OUT: Q2.3 (S), Q3.3 (S), Q4.3 (S), TP4.1, U1.2 (TX)
AREF: C27.2, C34.2, IC5.20 (AREF), R12.1, R21.2, R23.2
AVCC: C31.1, IC5.18 (AVCC), L1.1, R11.1
BUT_STATE: IC5.26 (PC3_(ADC3/PCINT11)), R28.1, S1.4, S2.3, SW1.S2
CLK0: IC1.10 (CLK0), IC3.14 (S0)
CLK1: IC1.9 (CLK1), IC3.2 (S1)
CLK2: IC1.6 (CLK2), IC4.1 (A1)
CTRL_OUT: C28.1, Q5.3 (S), TP6.1
DB4: IC5.30 (PD0_(RXD/PCINT16)), P3.1, U2.11 (DB4)
DB5: IC5.31 (PD1_(TXD/PCINT17)), P2.1, U2.12 (DB5)
DB6: IC5.32 (PD2_(INT0/PCINT18)), U2.13 (DB6)
DB7: IC5.1 (PD3_(PCINT19/OC2B/INT1)), U2.14 (DB7)
E: IC5.2 (PD4_(PCINT20/XCK/T0)), U2.6 (E)
F_IN: C2.2, C10.2, TP2.1
GND: C1.2, C3.2, C4.2, C6.2, C7.2, C8.2, C9.2, C12.1, C13.2, C15.1, C17.1, C18.1, C19.1, C20.1, C21.1, C26.1, C27.1, C30.2, C31.2, C32.2, C33.2, C34.1, IC1.8 (GND), IC2.1 (GND), IC3.7 (1A), IC3.8 (GND), IC3.15 (~OE2), IC4.7 (GND), IC5.3 (GND_1), IC5.5 (GND_2), IC5.21 (GND_3), J1.3, J2.2, J2.3, J3.1, J4.1, J5.2 (Ext), P6.1, Q2.1 (D), Q3.1 (D), Q4.1 (D), R3.2, R5.2, R8.1, R13.2, R20.1, R22.1, R24.1, R28.2, S3.3, SW1.C, U1.4 (GND), U1.5 (GND), U1.6 (GND), U2.1 (VSS), U2.5 (R/~W), U2.16 (K), U3.4 (V-)
HP_OUT: C14.1, IC5.13 (PB1_(PCINT1/OC1A)), R7.1
I: C24.2, IC5.24 (PC1_(ADC1/PCINT9)), R21.1, R22.2
unnamed: C2.1, Q1.3 (S), R3.1
unnamed: C4.1, D3.1, IC1.1 (VDD), IC1.7 (VDDO), R1.1, R2.1
unnamed: C5.1, Q1.1 (D), TP3.1
unnamed: C5.2, U1.3 (RX)
unnamed: C8.1, R4.2, R5.1, R6.1
unnamed: C10.1, IC3.9 (2A), R6.2
unnamed: C11.1, R7.2
unnamed: C11.2, J3.2, J3.4
unnamed: C13.1, R9.1, R10.2
unnamed: C14.2, J4.2
unnamed: C22.1, R14.1, R18.2, U3.6 (-)
unnamed: C22.2, C24.1, R18.1, U3.7
unnamed: C23.1, R16.1, R19.2, U3.2 (-)
unnamed: C23.2, C25.1, R19.1, U3.1
unnamed: C28.2, IC4.6 (Y2)
unnamed: C29.1, P1.1
unnamed: D1.2, J1.1
unnamed: D2.1, D3.2
unnamed: IC1.2 (XA), Y1.3
unnamed: IC1.3 (XB), Y1.1
unnamed: IC4.2 (B1), IC4.8 (Y3)
unnamed: IC4.3 (Y1), IC4.4 (A2), IC4.5 (B2)
unnamed: IC5.7 (PB6_(PCINT6/XTAL1/TOSC1)), Y2.3
unnamed: IC5.8 (PB7_(PCINT7/XTAL2/TOSC2)), Y2.1
unnamed: J2.1, J5.1 (In), TP1.1, U1.7 (ANT2), U1.8 (ANT1)
unnamed: Q2.2 (G), Q3.2 (G), Q4.2 (G), Q5.1 (D), R8.2, TP5.1
unnamed: Q5.2 (G), R9.2
unnamed: R15.1, U3.5 (+)
unnamed: R17.1, U3.3 (+)
unnamed: R20.2, RV1.3
unnamed: R25.2, S1.1
unnamed: R26.2, S2.1
unnamed: RV1.2, U2.3 (VO)
PB0: C7.1, IC4.9 (A3), IC4.10 (B3), IC5.12 (PB0_(PCINT0/CLKO/ICP1)), Q1.2 (G)
PB4: C15.2, C16.2, IC5.16 (PB4_(PCINT4/MISO)), J4.3, R11.2
PB5: IC5.17 (PB5_(SCK/PCINT5)), J4.4
PC2: C16.1, IC5.25 (PC2_(ADC2/PCINT10)), R12.2, R13.1
PD6: IC5.10 (PD6_(PCINT22/OC0A/AIN0)), SW1.B
PD7: IC5.11 (PD7_(PCINT23/AIN1)), SW1.A
Q: C25.2, IC5.23 (PC0_(ADC0/PCINT8)), R23.1, R24.2
RESET: C29.2, IC5.29 (PC6_(~RESET/PCINT14)), R29.1, S3.1
RS: IC1.5 (SDA), IC5.27 (PC4_(ADC4/SDA/PCINT12)), R1.2, U2.4 (RS)
SCL: IC1.4 (SCL), IC5.28 (PC5_(ADC5/SCL/PCINT13)), R2.2
TX_CTRL_1: IC5.14 (PB2_(PCINT2/8SS/OC1B)), R10.1
uC_VCC: C32.1, C33.1, IC5.4 (VCC_1), IC5.6 (VCC_2), L1.2, L2.2

Notes on the sheet:
Flashing connector

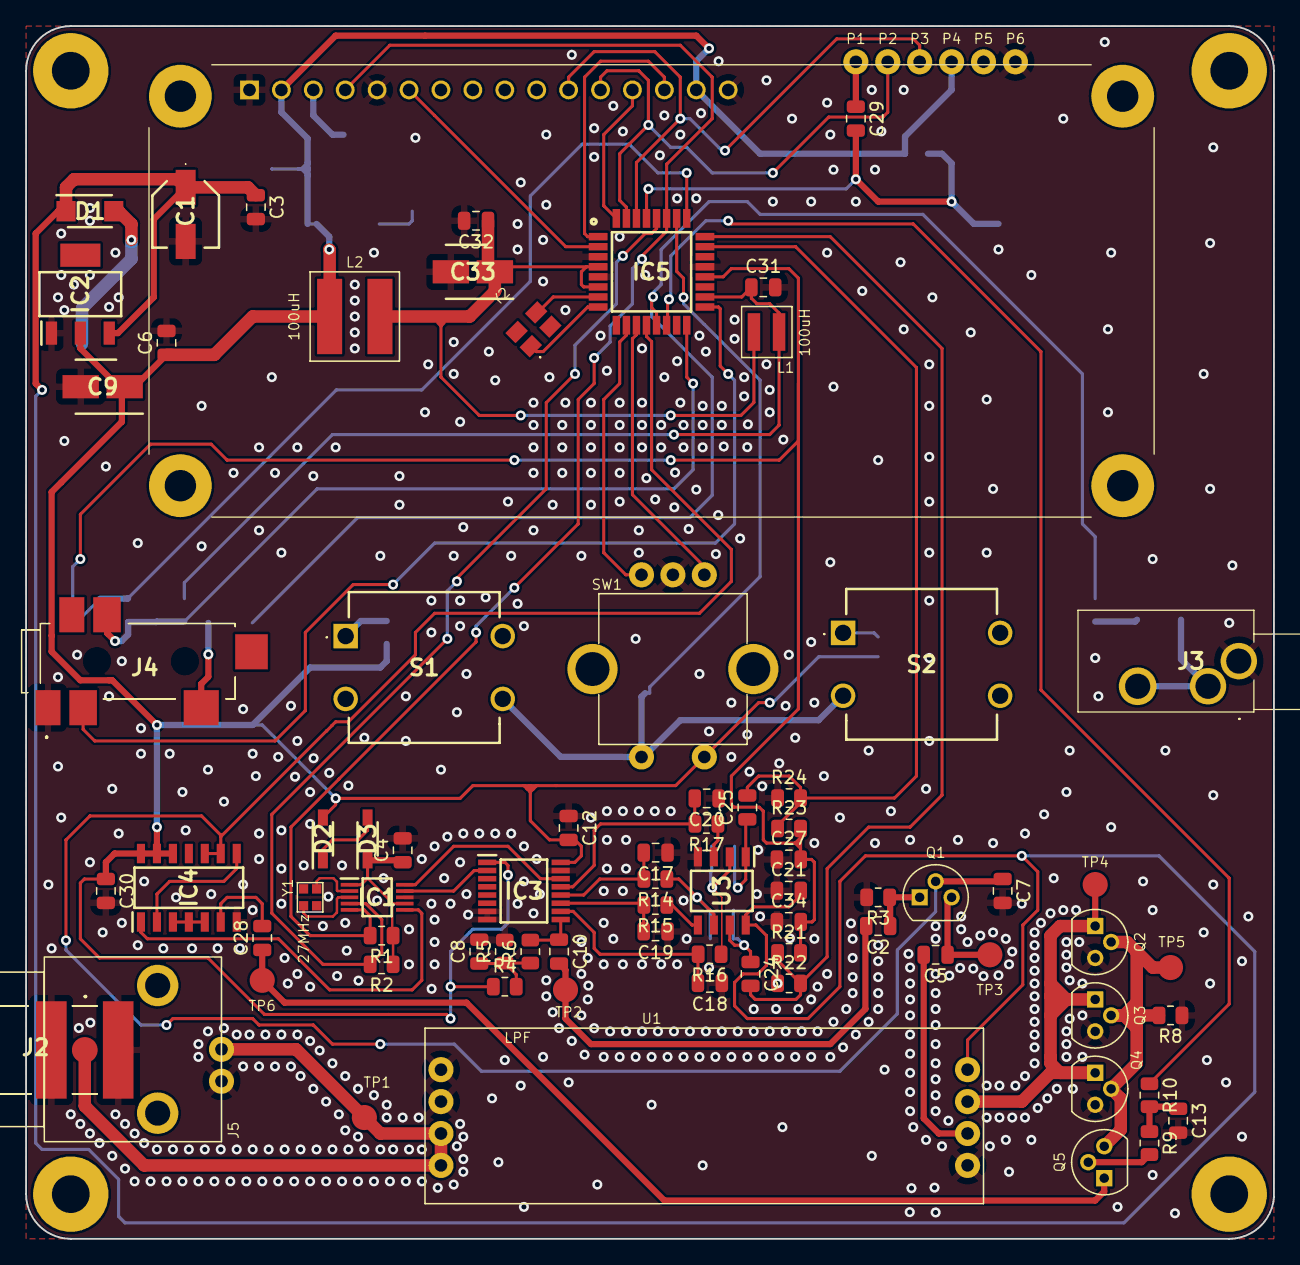
[picture p65: board uSDX_Transceiver_SMD.kicad_pcb from above]

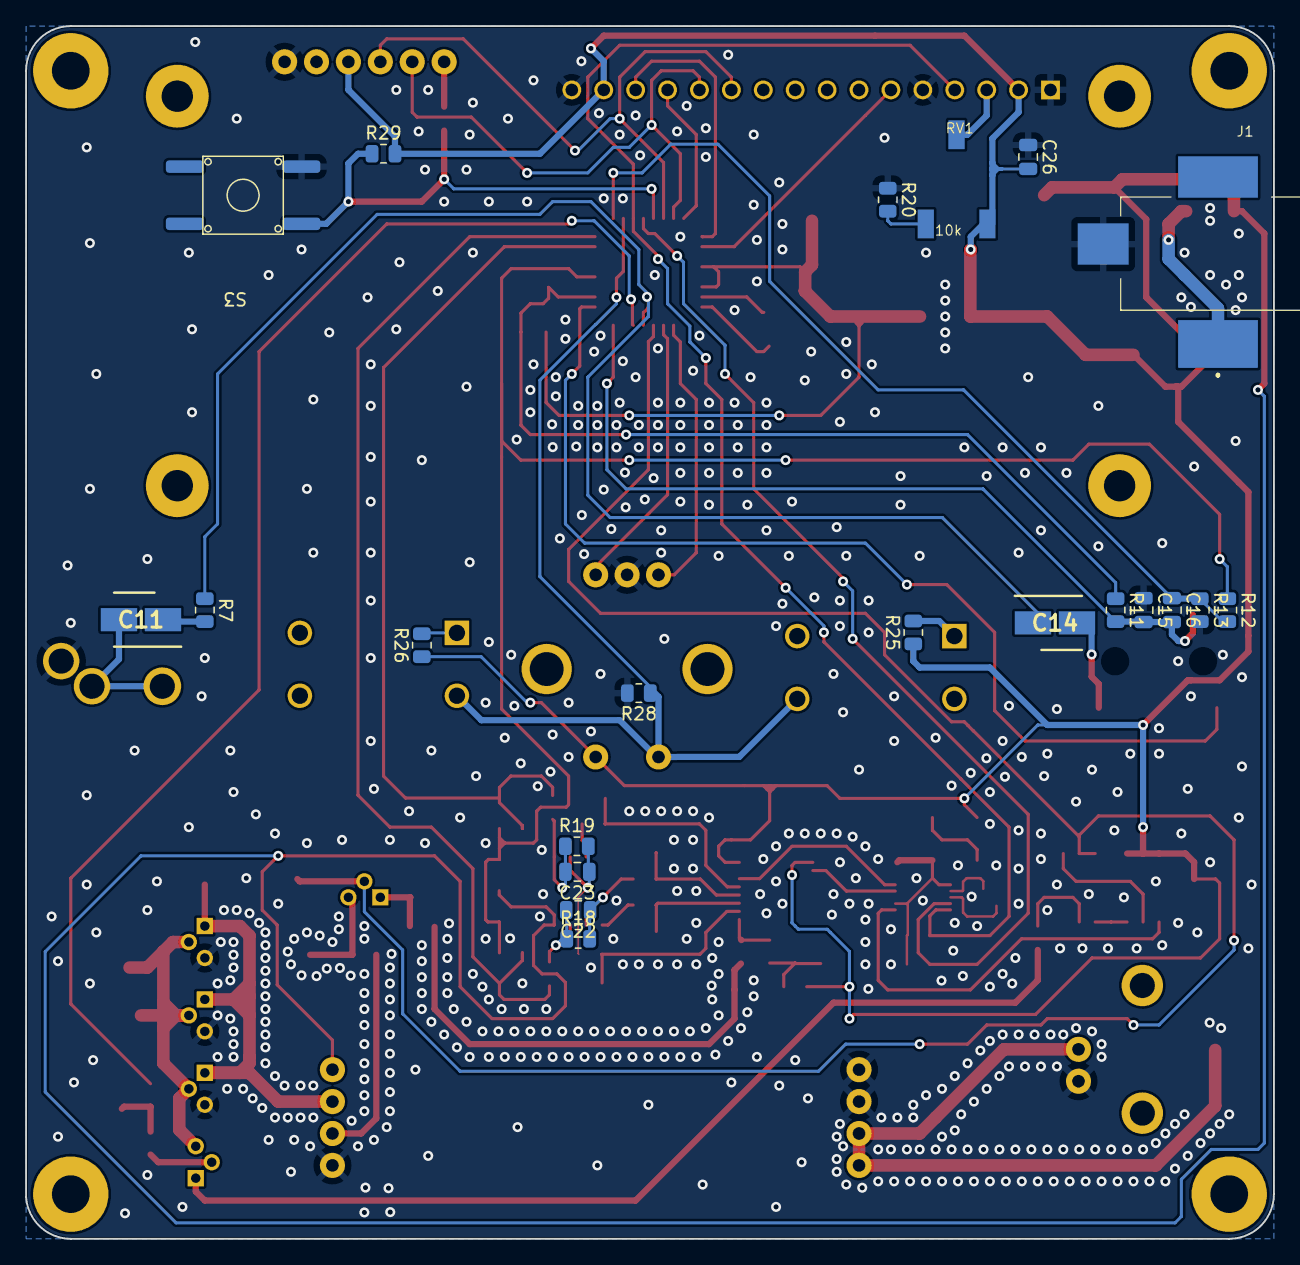
[picture p66: board uSDX_Transceiver_SMD.kicad_pcb from below]

Board: 2 copper layers, 99.3 x 96.5 mm, 108 parts (21 on the bottom side), 68 nets.

Other parts of the board:
 : MountingHole_3mm_Pad
 #2,  #3,  #4: MountingHole_3mm_Pad
