liviu201/uSDX_variant/Hardware/uSDX_BPF/uSDX_BPF.kicad_pcb

## KiCad design Hardware/uSDX_BPF/uSDX_BPF.kicad_pcb (2022-01-16)

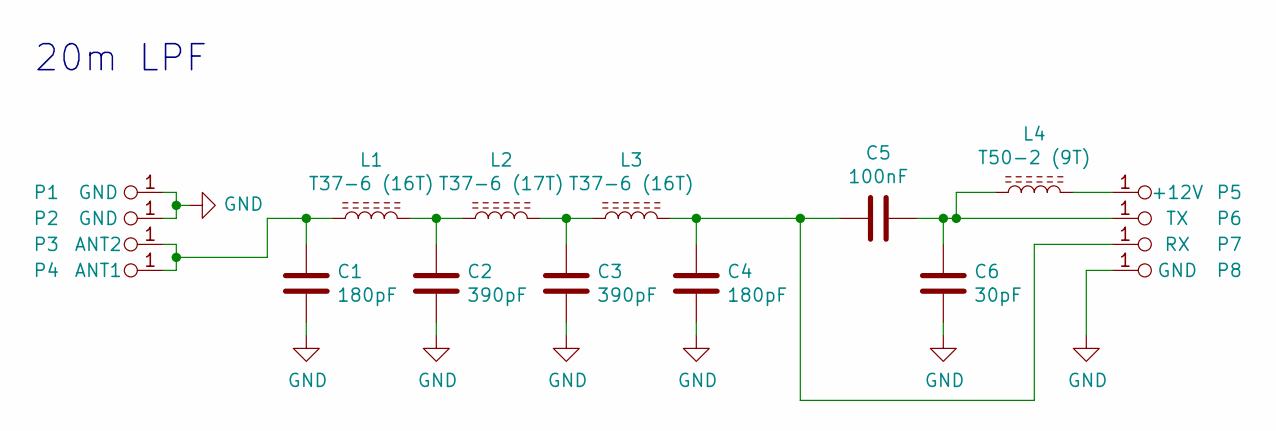
[picture p67: schematic uSDX_BPF.kicad_sch]

Parts:
C1, C4: 180pF; C_Disc_D3.0mm_W1.6mm_P2.50mm
C2, C3: 390pF; C_Disc_D3.0mm_W1.6mm_P2.50mm
C5: 100nF; C_Disc_D3.0mm_W1.6mm_P2.50mm
C6: 30pF; C_Disc_D3.0mm_W1.6mm_P2.50mm
L1, L3: T37-6 (16T); L_Toroid_Vertical_L10.0mm_W5.0mm_P5.08mm
L2: T37-6 (17T); L_Toroid_Vertical_L10.0mm_W5.0mm_P5.08mm
L4: T50-2 (9T); L_Toroid_Vertical_L10.0mm_W5.0mm_P5.08mm
P1, P2, P8: GND; pin
P3: ANT2; pin
P4: ANT1; pin
P5: +12V; pin
P6: TX; pin
P7: RX; pin

Connections:
GND: C1.2, C2.2, C3.2, C4.2, C6.2, P1.1, P2.1, P8.1
unnamed: C1.1, L1.1, P3.1, P4.1
unnamed: C2.1, L1.2, L2.1
unnamed: C3.1, L2.2, L3.1
unnamed: C4.1, C5.2, L3.2, P7.1
unnamed: C5.1, C6.1, L4.1, P6.1
unnamed: L4.2, P5.1

Notes on the sheet:
20m LPF

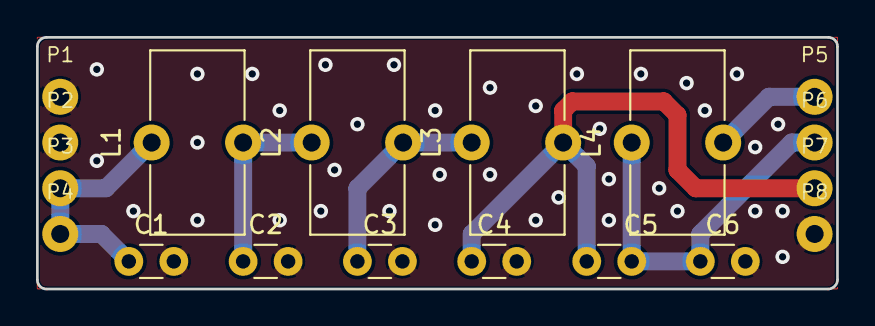
[picture p68: board uSDX_BPF.kicad_pcb from above]

Board: 2 copper layers, 44.5 x 14.0 mm, 18 parts (0 on the bottom side), 7 nets.
