liviu201/uSDX_variant/(commit log)

2021-07-26 initial commit - HW schematic improved
    [SDR_SSB-B_Cu.gbl, SDR_SSB-B_Mask.gbs, SDR_SSB-B_SilkS.gbo, SDR_SSB-Edge_Cuts.gm1, SDR_SSB-F_Cu.gtl, SDR_SSB-F_Mask.gts, SDR_SSB-F_SilkS.gto, SDR_SSB-NPTH.drl]
2021-09-25 updated component footprints
    [Clock generators.ods, SDR_SSB.csv, SDR_SSB.ods, SDR_SSB.sch, my_design.xlsx]
2021-10-12 updated HW design
    [Clock generators.ods, SDR_SSB.kicad_pcb, SDR_SSB.sch]
2021-12-31 updated the HW design
    [ABLS-20.000MHZ-20-B-3-H-T.FCStd, Connect.step, Fusion.step, RASM722BKZ.FCStd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]
2022-01-01 completed the HW design
    [uSDX_SMD.kicad_pcb, uSDX_SMD.kicad_sch]
2022-01-09 updated the hardware design
    [1613_14.step, 16PJ200.step, 1N4007F.step, 1N4148W_R2_00001.step, 830108207209.step, ATMEGA16A-AU.step, ATMEGA328P-ANR.step, AtMega328p.FCStd]
2022-01-12 modified the HW design, corrected mistakes
    [AZ1117CH-5.0TRG1DITR-ND.step, Body.step, angled_socket_header.FCStd, angled_socket_header.step, trimmer.FCStd, trimmer.step, uSDX_SMD.kicad_pcb]
2022-01-13 updated the HW desigin and 3D models
    [27Mhz_crystal.FCStd, 27Mhz_crystal.step, resetButton.step, reset_button.FCStd, uSDX_SMD.kicad_pcb, uSDX_SMD.kicad_sch]
2022-01-15 updated the 3D models
    [BPF_board.FCStd, Toroid.FCStd, Toroid.step, filterStandoff.FCStd, filterStandoff.step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]
2022-01-15 updated the project with transferrable libraries
    [C_0805_2012Metric.step, C_Disc_D3.0mm_W1.6mm_P2.50mm.step, R_0805_2012Metric.step, uSDX_BPF.kicad_pcb, uSDX_BPF.kicad_sch, uSDX_SMD.kicad_pcb, uSDX_SMD.kicad_sch]
2022-01-16 update library locations
    [uSDX_BPF.kicad_pcb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]
2022-01-30 added CMake project and lcd driver
2022-02-15 fixed CMake configuration, added test code for the lcd driver
2022-07-19 added tests for the LCD
    [uSDX_Transceiver_SMD.sch]
